F6ITU/ET-EER-Project/DJ1MR/2018 EER-ET documentation/Hermes-Interface-EER-Menu.pdf

# 2. Pulse Width Modulation (PWM) using Hermes and PowerSDR software

DJ1MR

# PWM principles, PWM spectrum

■ | The width of pulses is varied in proportion to the instantaneous amplitude of the SSB envelope

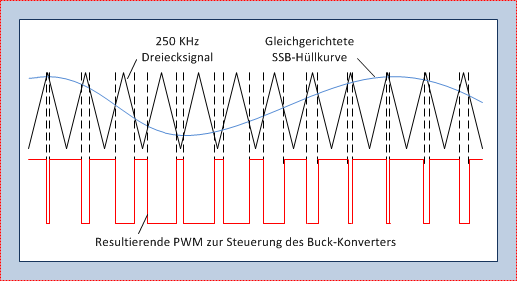
[picture p49: figure]

■ | The digital PWM signal has more bandwidth than the original SSB signal (25 to 32 KHz)
■ | Around the switching carrier and the harmonic carriers you see also the digital PWM LSB and USB

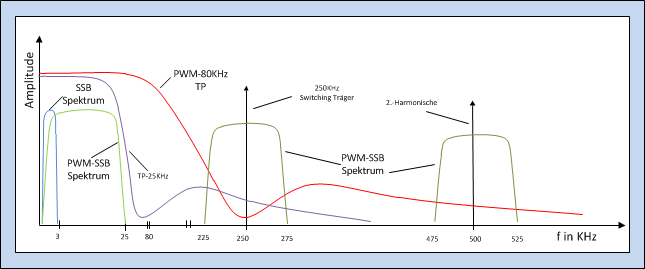
[picture p50: figure]

# Getting PWM from Hermes board on J14/Pin2

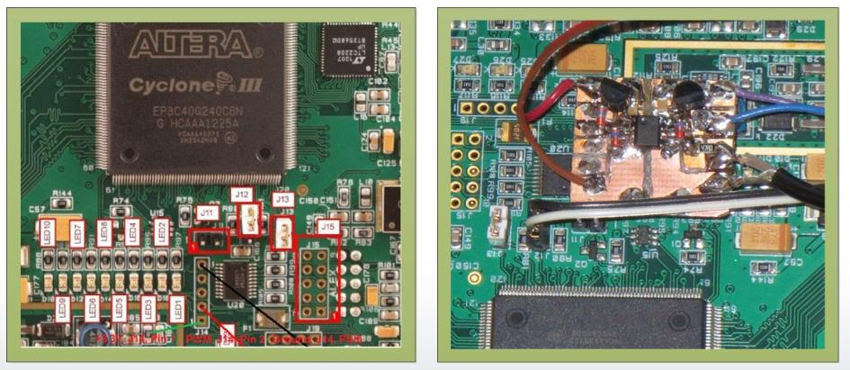
[picture p51: figure]

DJ1MR | 3

# Circuit diagram PWM adapter

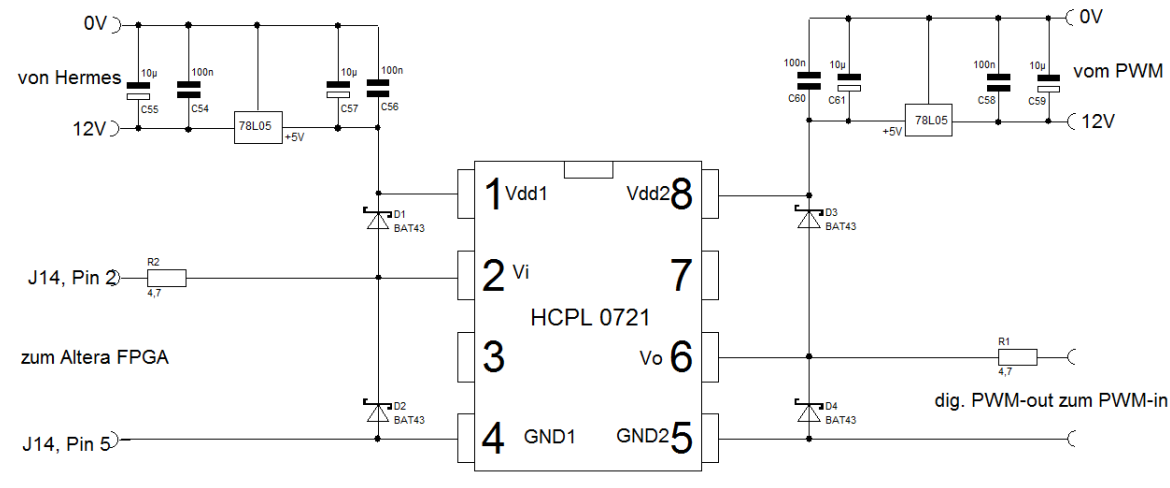
[picture p52: figure]

DJ1MR | 4

# PWM Two Tone and Analog PWM Envelope Signal

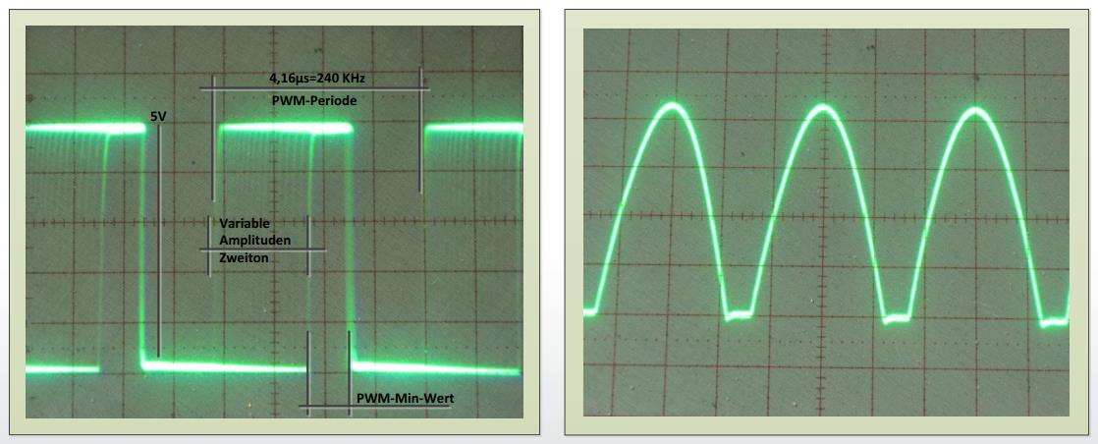
[picture p53: figure]

DJ1MR | 5
Digital 5 volts PWM | Filtered Analog Envelope Signal

# EER menu in Power SDR software

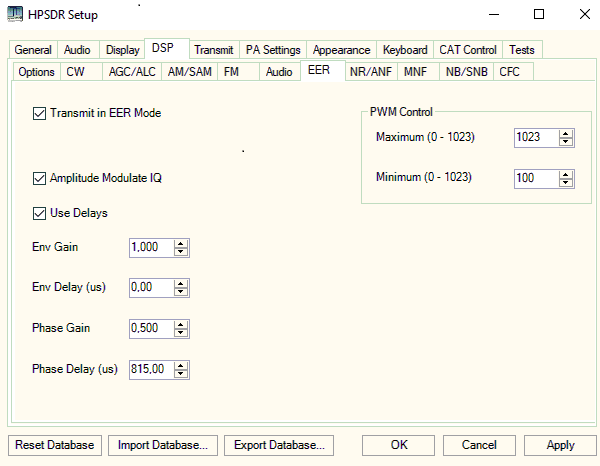
[picture p54: figure]

# PWM control function in PowerSDR

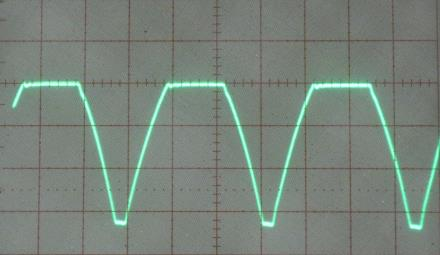
[picture p55: figure]
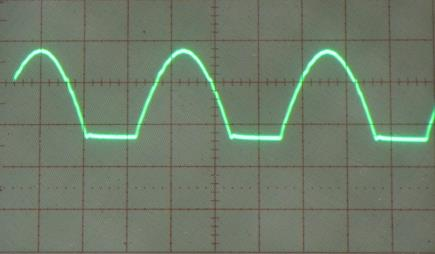
[picture p56: figure]
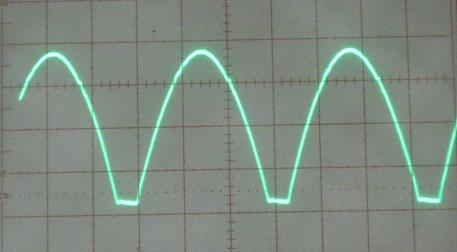
[picture p57: figure]
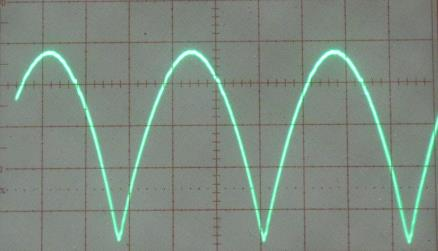
[picture p58: figure]

EER Mode | ET Mode | ET Mode | ET Mode

# Time alinment between Envelope and Phase

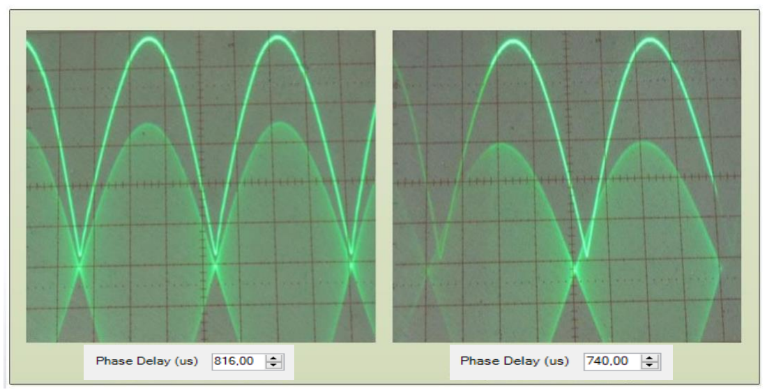
[picture p59: figure]

DJ1MR | 8

# Two types of SSB Phase Signals

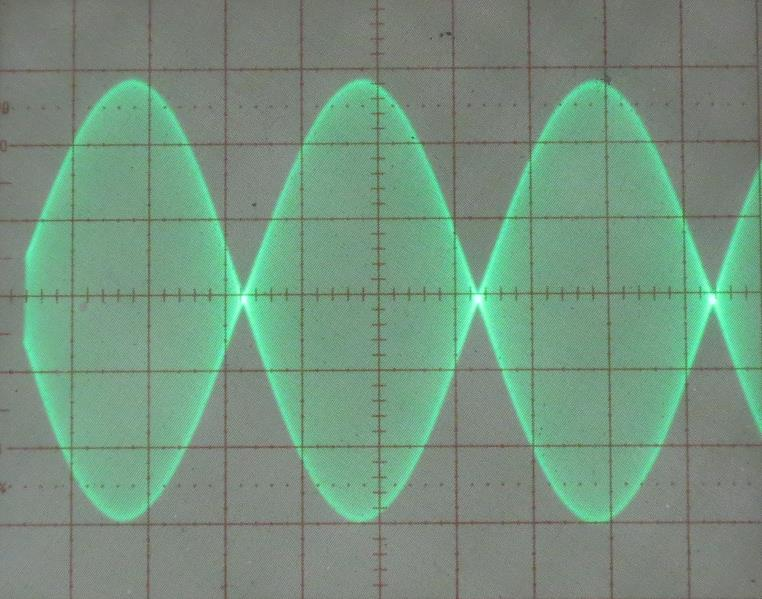
[picture p60: figure]
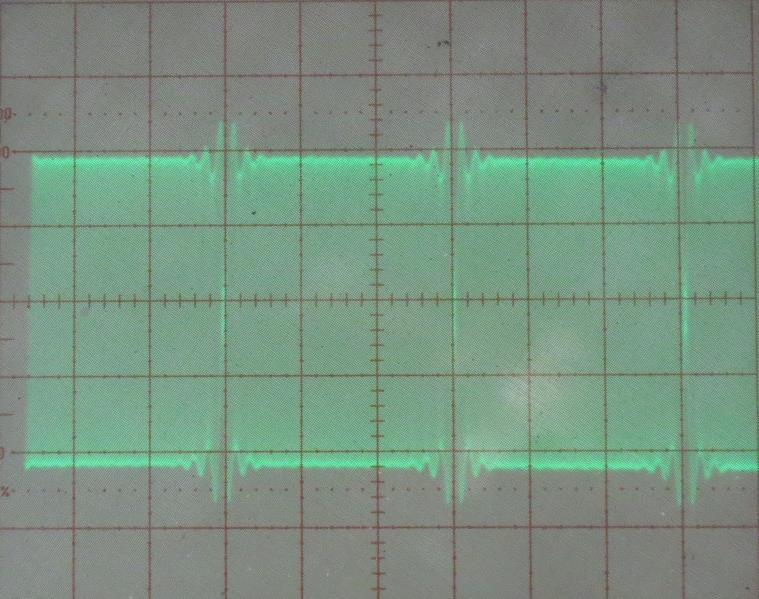
[picture p61: figure]

Amplitude Modulate Phase Signal | Constant Amplitude Phase Signal

# PWM Class S-modulator

■ | In PWM the most widely used high-level modulator is class S
■ | A transistor and diode act as a two-pole switch to generate a rectangular waveform with a switching frequency several times that of the output signal (for instance 240 KHz and higher).

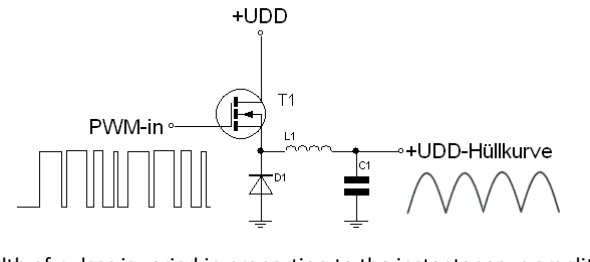
[picture p62: figure]

■ | The width of pulses is varied in proportion to the instantaneous amplitude of the desired output signal, which is recovered by a low-pass filter.
■ | Class S is ideally 100% efficient and it can have high efficiency over a wide dynamic range.

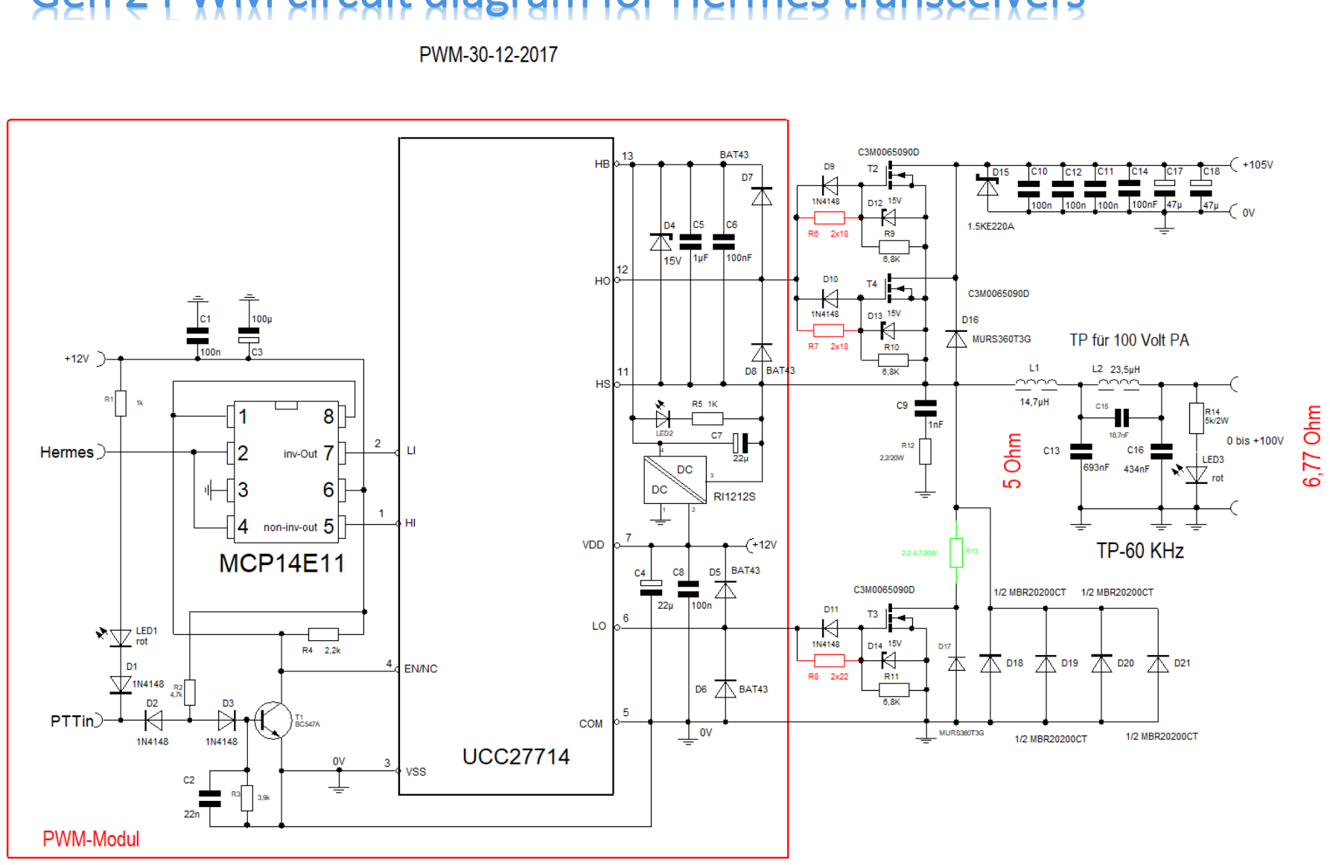
[picture p63: figure]

## Gen 2 PWM circuit diagram for Hermes transceivers

# Impulses on HS PIN UCC27714

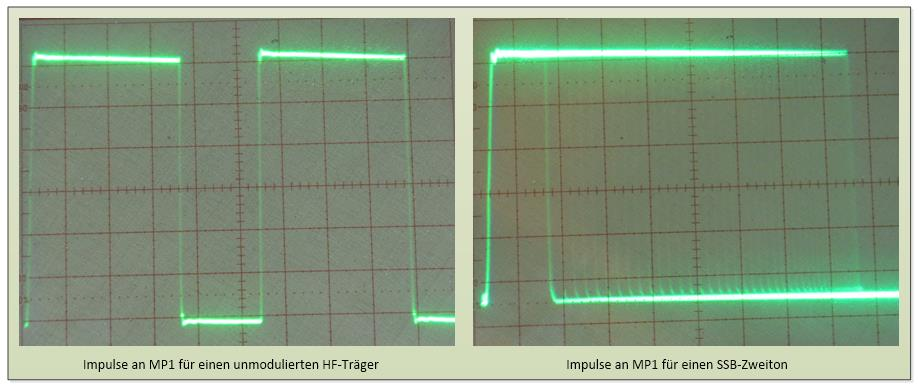
[picture p64: figure]

DJ1MR | 12

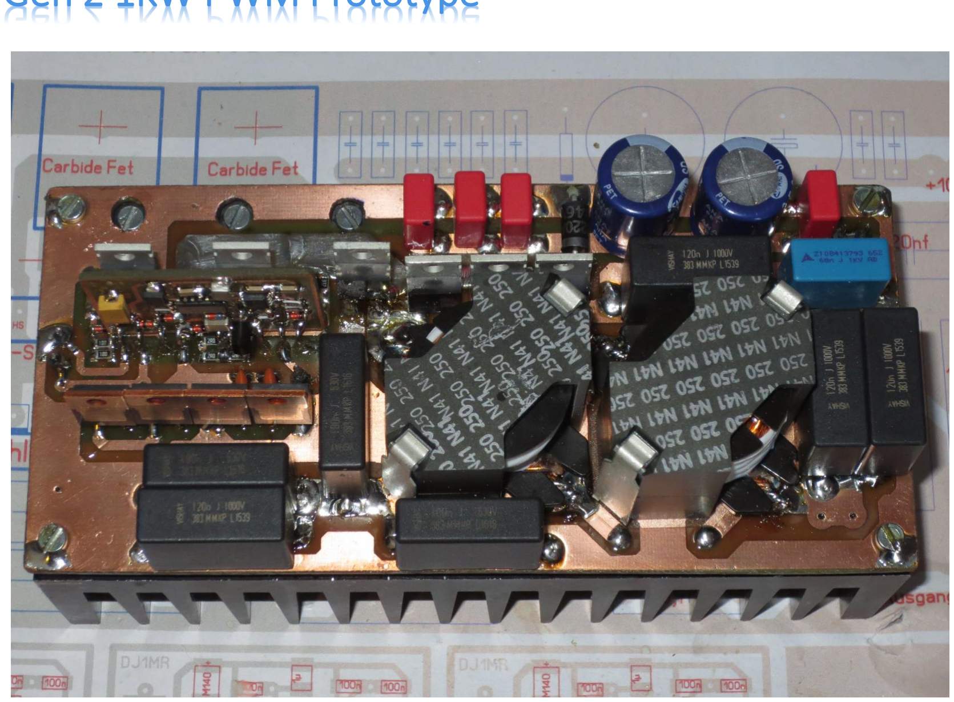
[picture p65: figure]

## Gen 2 1KW PWM Prototype

# PWM control driver modul

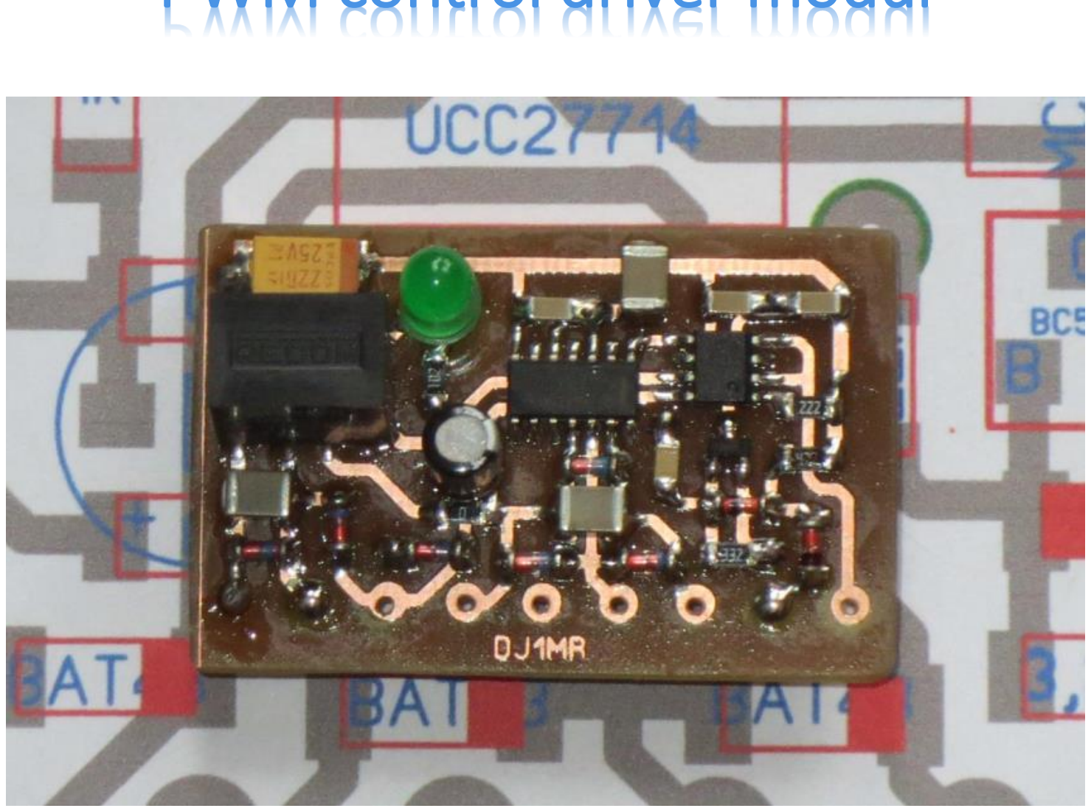
[picture p66: figure]

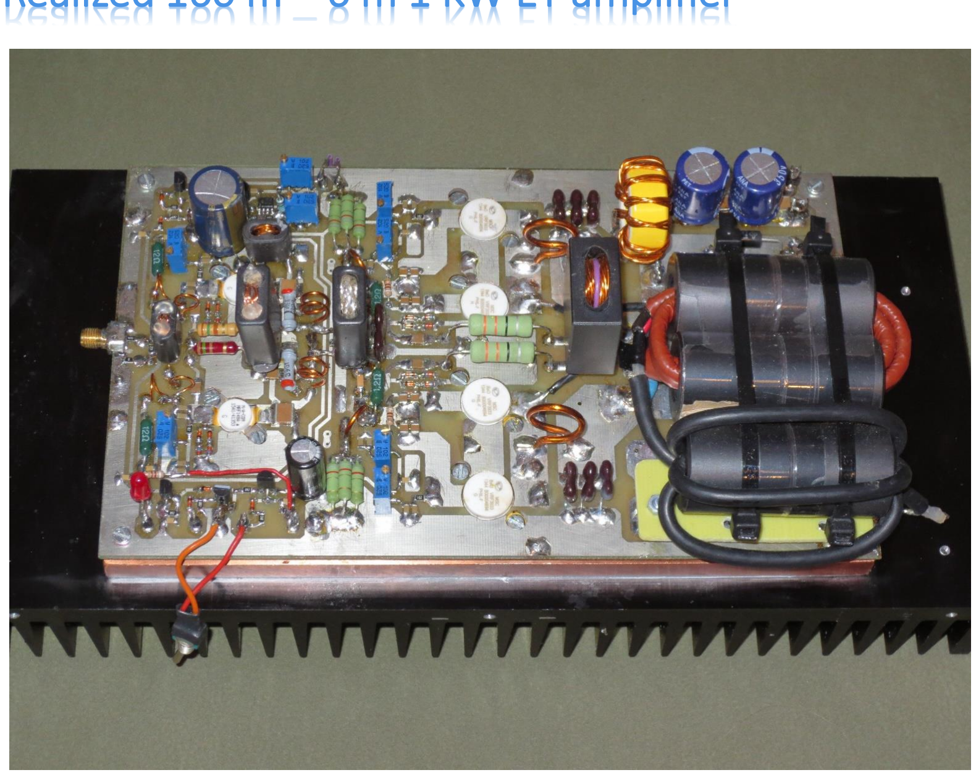
[picture p67: figure]

## Realized 160 m – 6 m 1 KW ET amplifier

# IMD3 with linearity 750 W out

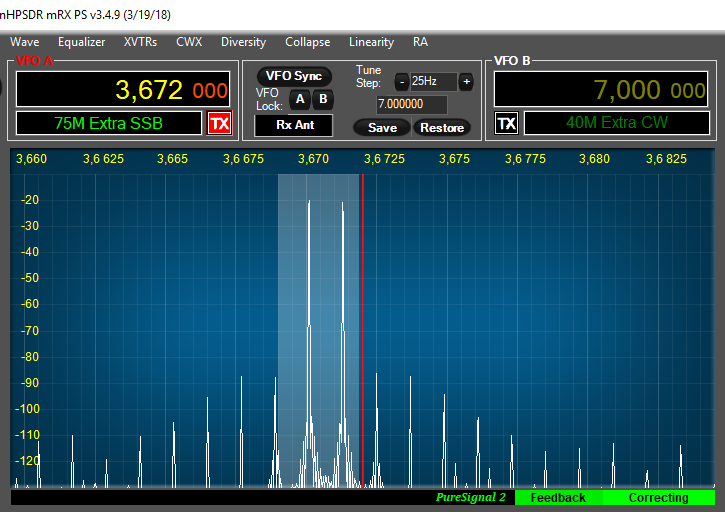
[picture p68: figure]

DJ1MR | 16

# Linearity correction with PowerSDR

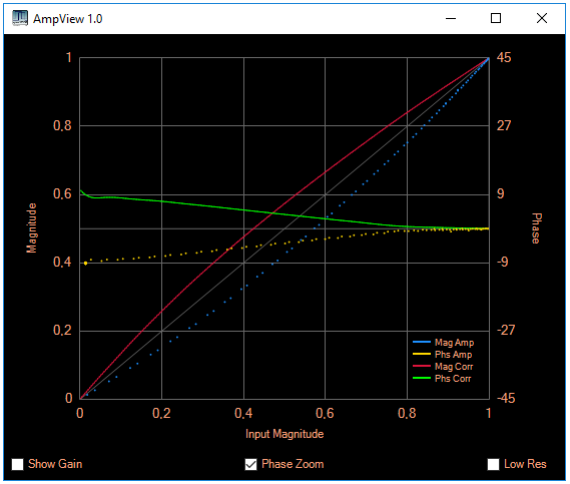
[picture p69: figure]

■ | AmpView ET PA 750 Watt
■ | No memory effect
