F6ITU/ET-EER-Project/DJ1MR/2018 EER-ET documentation/Vortrag-HAM-2018-DJ1MR-V3.pdf

# TRANSMITTER ARCHITECTURES FOR HIGH EFFICIENCY AMPLIFICATION

## using

## PowerSDRsoftware and Hermes firmware

Ruediger Moeller/callsign DJ1MR

## The dissipated heat dilemma

■ | Legacy linear RF power amplifiers consume large amounts of energy,
■ | dissipate heat take up space in RF power amplifiers,
■ | large heatsinks are increasing the weight and the expenses of the PA,
■ | fans are generating often too much noise,
■ | Significantly more efficient PA technology will be the future goal
■ | Basic requirements for future power amplifier technology
□ | high linearity,
□ | high efficiency
□ | smaller dimensions
□ | greater output power levels

### DJ1MR

# 1. Supply Modulated Transmitters

## Principles of Supply Modulated Transmitters

■ | Envelope Elimination and Restoration (EER), (Kahn technique)
■ | Hybrid Envelope Elimination and Restoration (H-EER)
■ | Envelope Tracking (ET).
■ | EER
■ | EER technique combines a highly efficient, but nonlinear RF PA with a highly
efficient envelope amplifier to implement a high-efficiency linear RF PA.

□ In its classic form, a limiter eliminates the envelope and allowing the constant-amplitude phase modulated carrier to be amplified efficiently by class-C, class-D, class-E, or class-F RF PAs.

□ Amplitude modulation of the final RF PA restores the envelope to the phase-modulated carrier creating an amplified replica of the input signal.

## Transmitter based upon the Kahn EER technique

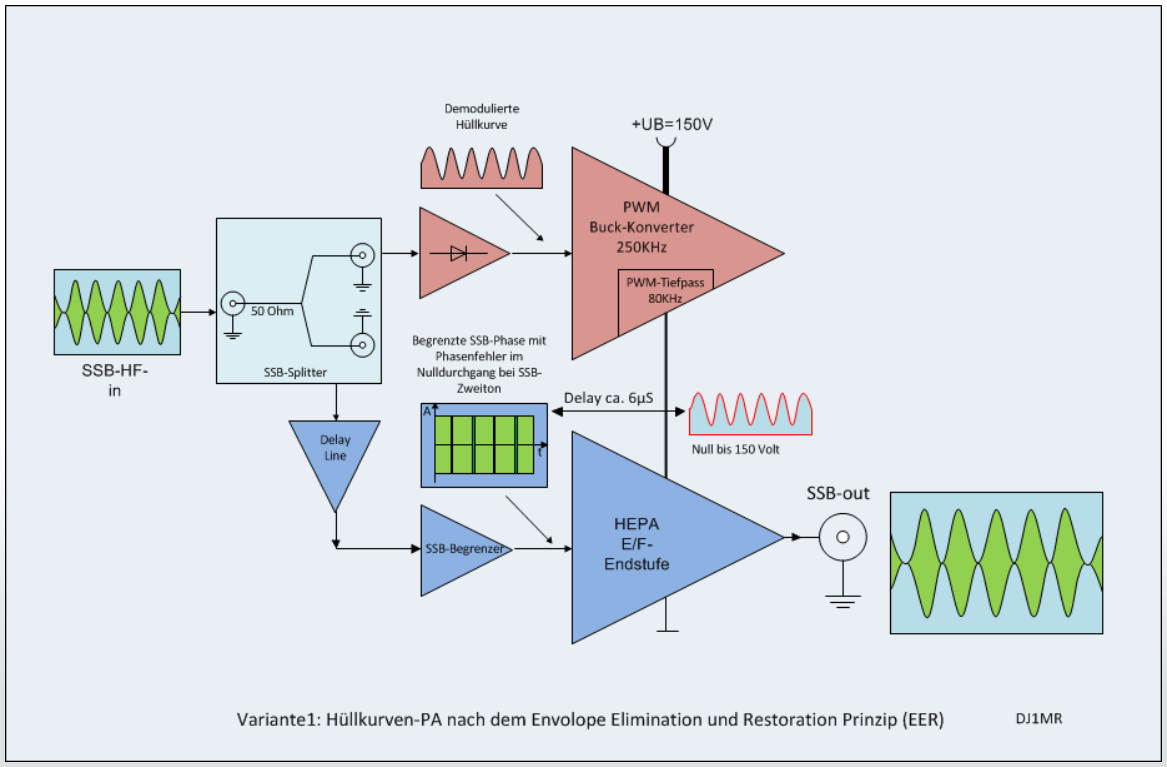
[picture p92: figure]

## Principles of supply-modulated transmitters

■ | ET
■ | the input signal of the PA is not a constant envelope signal with phase information but a complex-signal envelope
■ | the ET transmitter has advantages of the H-EER transmitter, such as less precise time alignment between the envelope and RF paths.
■ | the envelope signal injected into the PA is no longer the original envelope and is adjusted for optimized performance
■ | V-offset is a bit greater than the knee voltage of the power mosfets and the severely nonlinear behavior caused by nonlinear capacitance impedance mismatch of the PA is prevented
■ | traditionally, linear PAs such as class-AB amplifiers, are utilized in ET transmitters to obtain good linearity with high efficiency
■ | the burden of sufficient IMD3 lays only on the HEPA

## Transmitter based upon ET technique

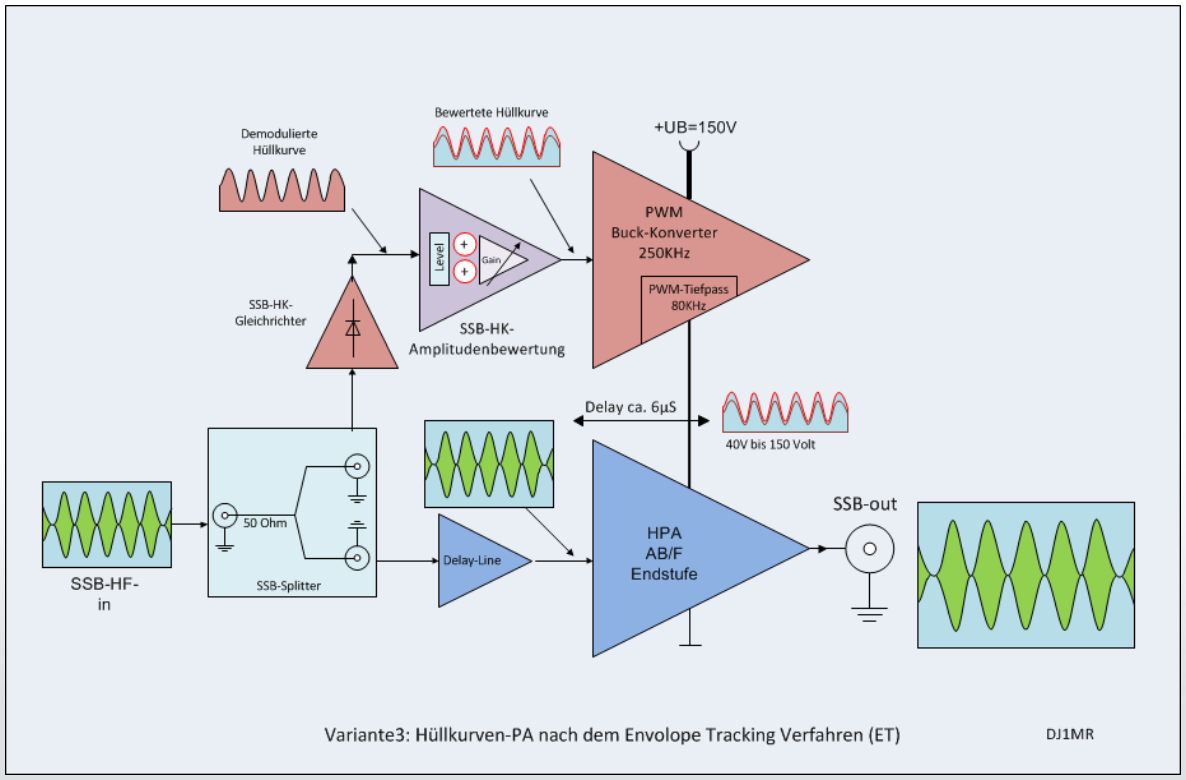
[picture p93: figure]

## Modulation schemes of the power supply

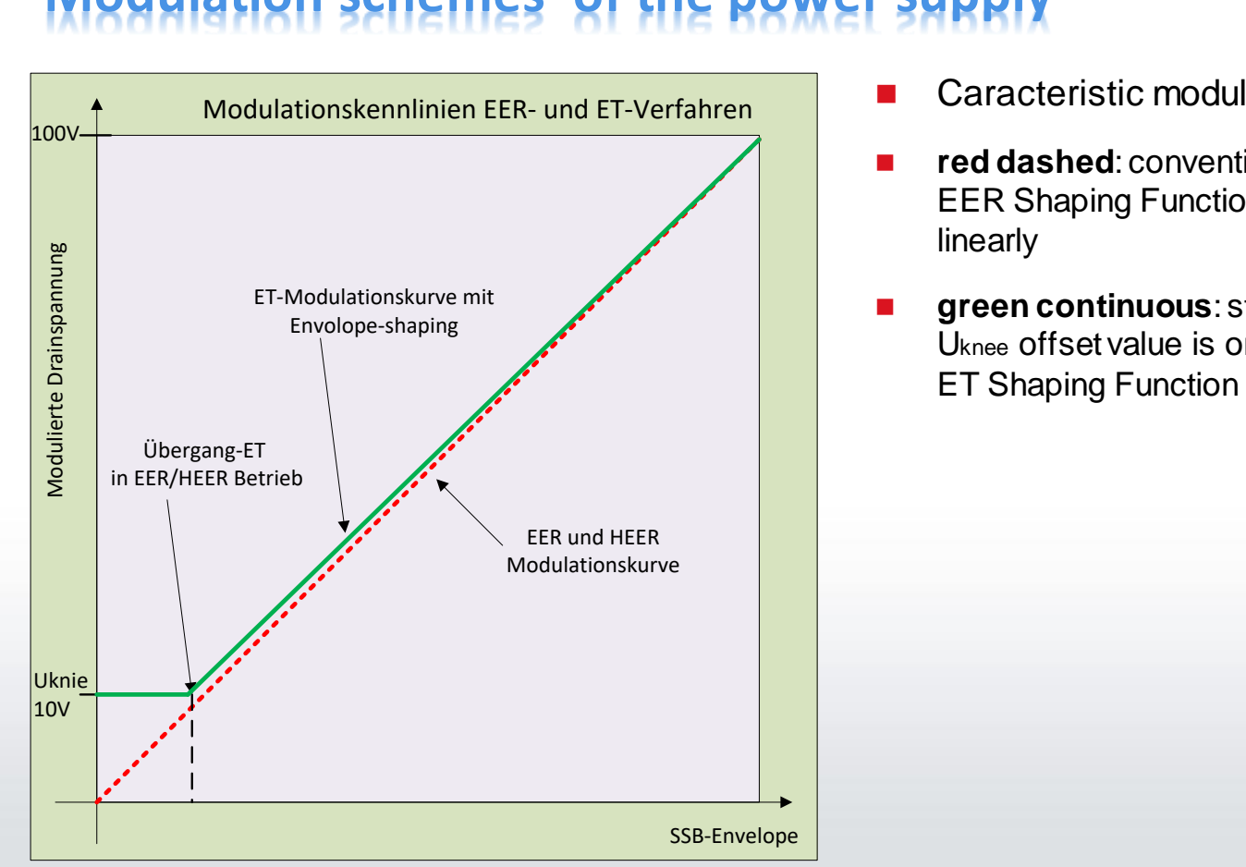
[picture p94: figure]
linearly; ET Shaping Function; Übergang-ET in EER/HEER Betrieb; EER und HEER Modulationskurve; SSB-Envelope

■ | Caracteristic modulation lines
■ | red dashed: conventional EER/H- EER Shaping Function, increases
■ | green continuous: starts with Uknee offset value is one Type of

# DJ1MR Modulierte Drainspannung Uknie 10V

ET-Modulationskurve mit Envolope-shaping

Modulationskennlinien EER- und ET-Verfahren

# 2. Pulse Width Modulation (PWM) using Hermes and PowerSDR software

## PWM principles, PWM spectrum

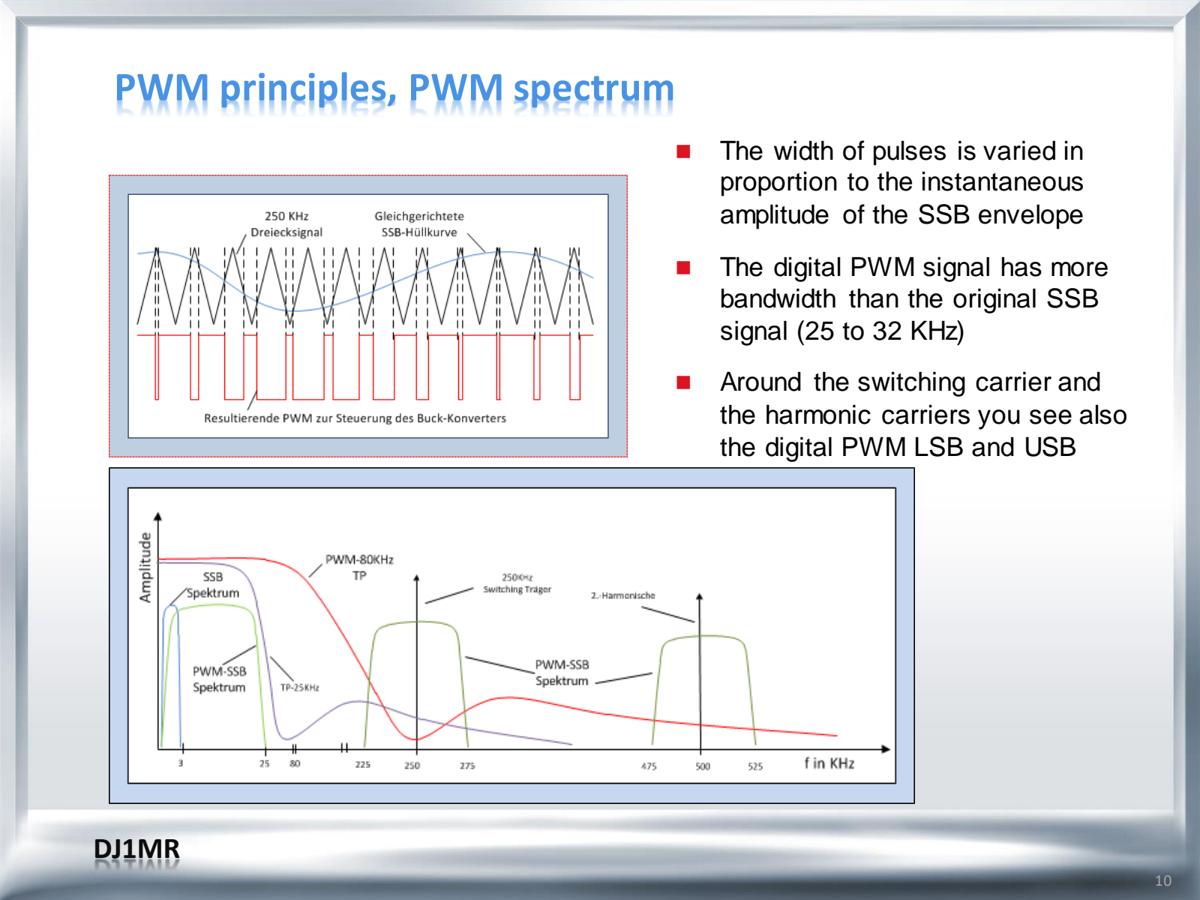
[picture p95: page 10]

■ | The width of pulses is varied in proportion to the instantaneous amplitude of the SSB envelope
■ | The digital PWM signal has more bandwidth than the original SSB signal (25 to 32 KHz)
■ | Around the switching carrier and the harmonic carriers you see also the digital PWM LSB and USB

## Getting PWM from Hermes board on J14/Pin2

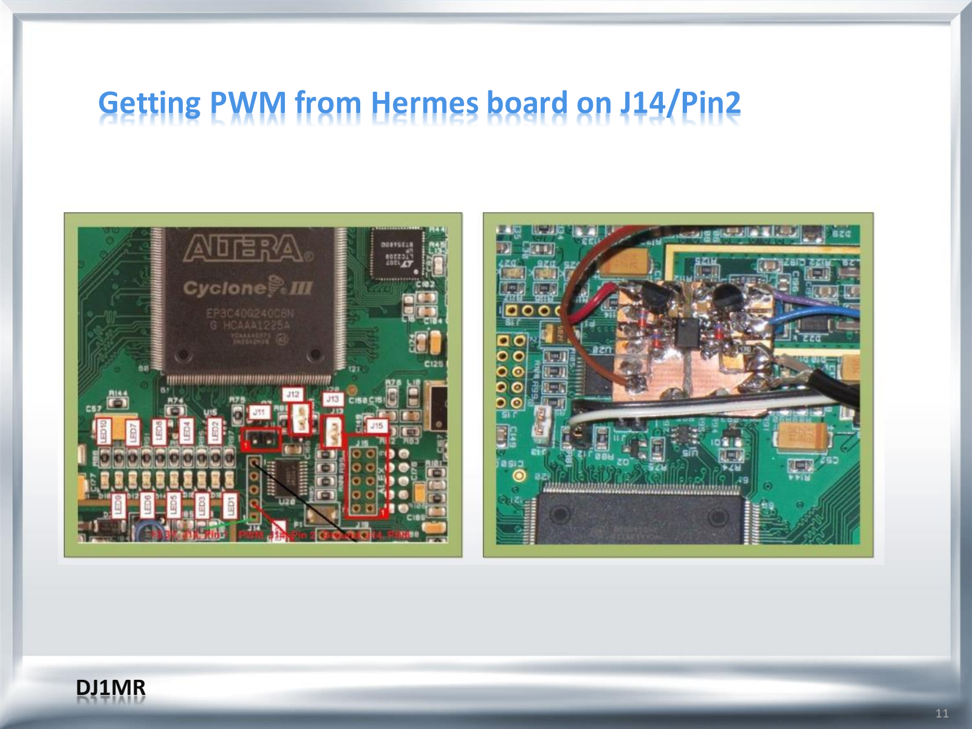
[picture p96: page 11]

## Circuit diagram PWM adapter

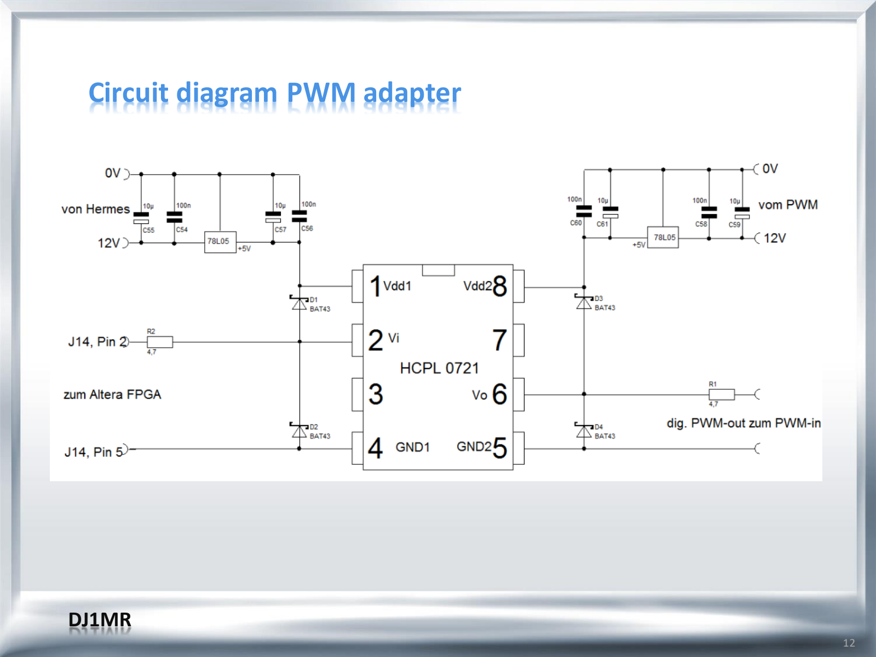
[picture p97: page 12]

## PWM Two Tone and Analog PWM Envelope Signal

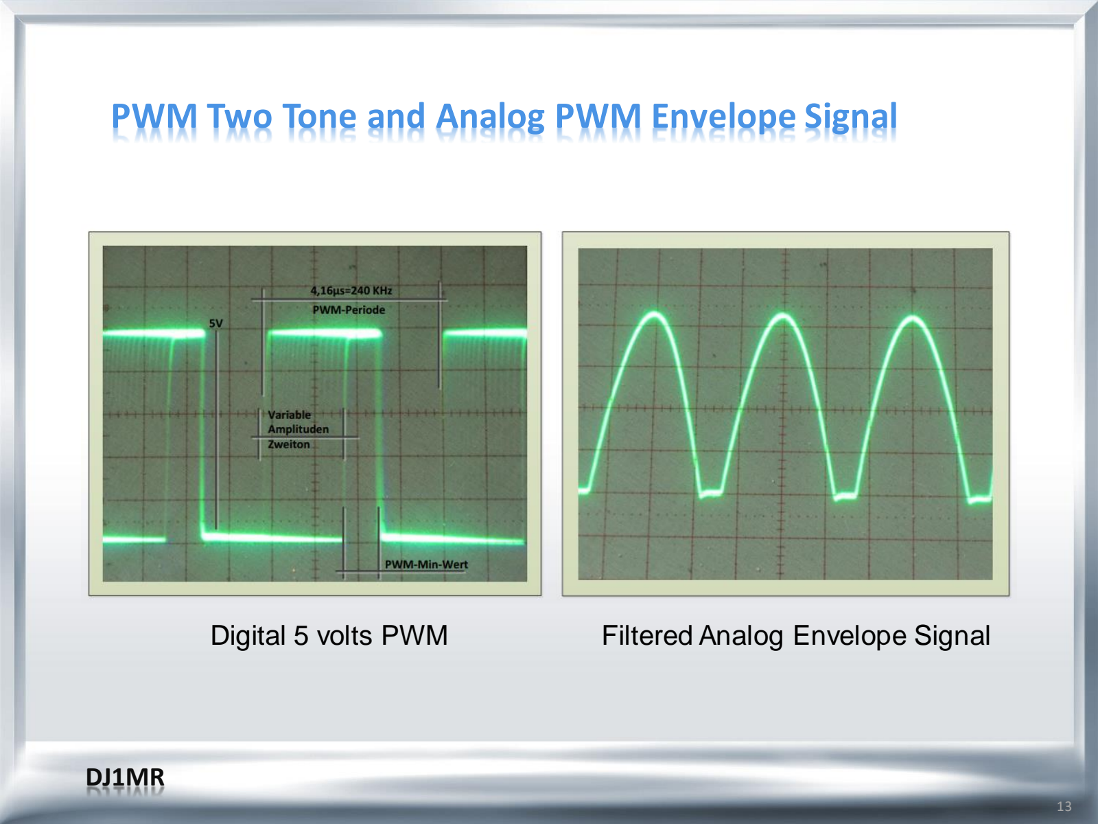
[picture p98: page 13]

Digital 5 volts PWM | Filtered Analog Envelope Signal

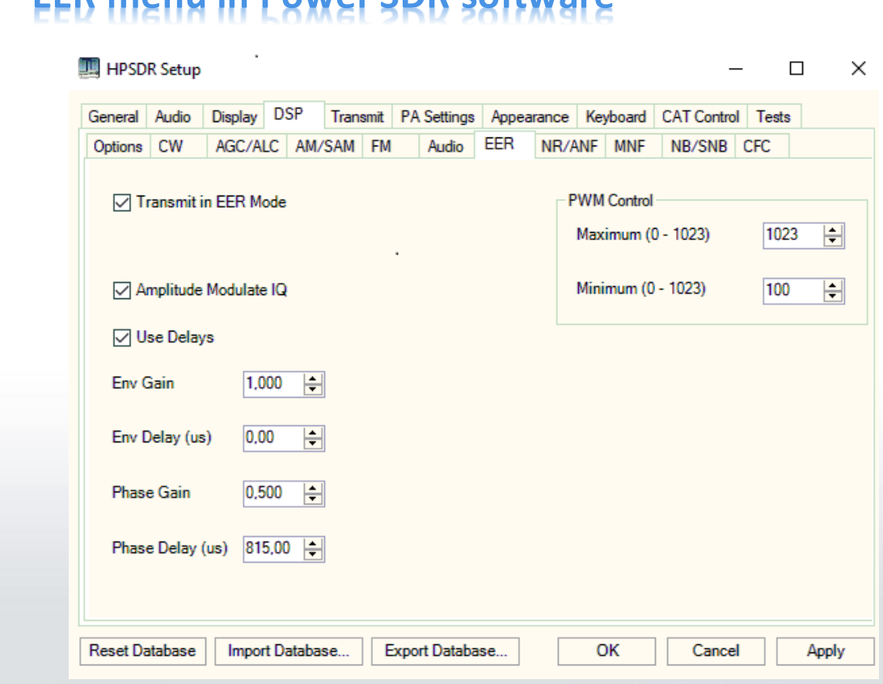
[picture p99: figure]

## EER menu in Power SDR software

## PWM control function in PowerSDR

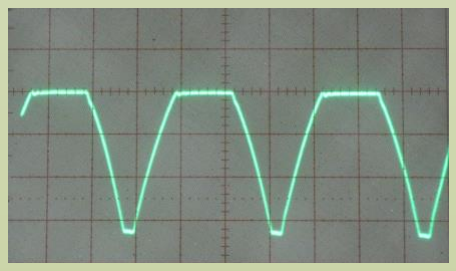
[picture p100: figure]
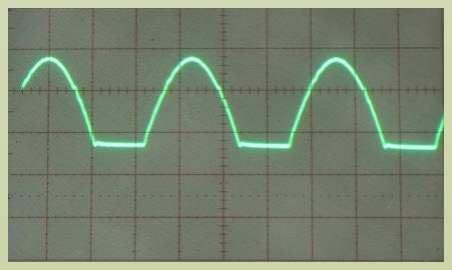
[picture p101: figure]
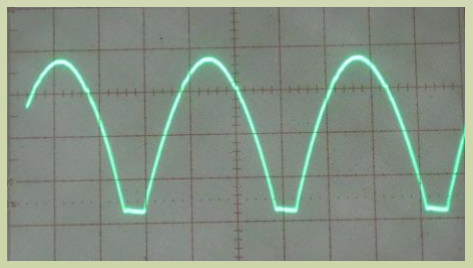
[picture p102: figure]
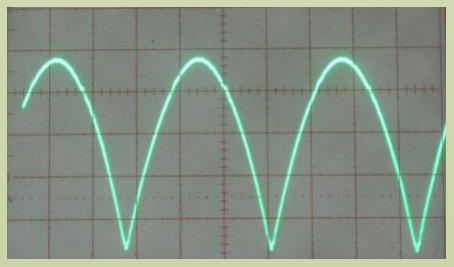
[picture p103: figure]

EER Mode | ET Mode | ET Mode | ET Mode

## Time alinment between Envelope and Phase

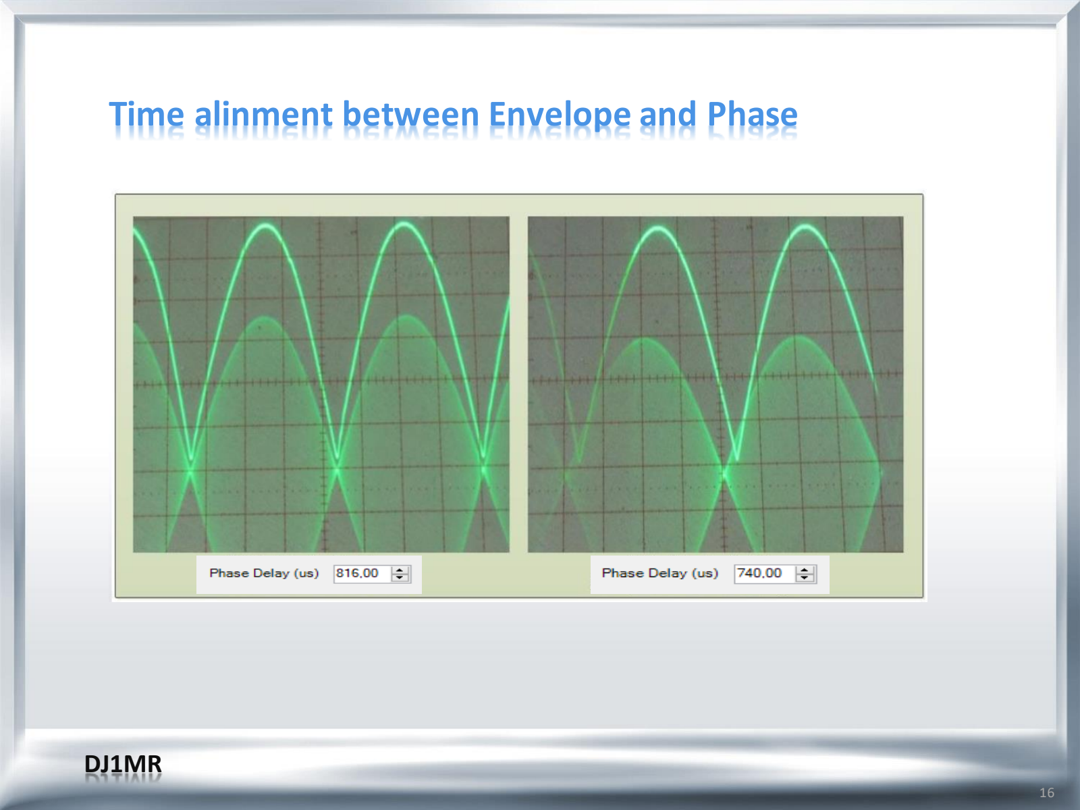
[picture p104: page 16]

## Two types of SSB Phase Signals

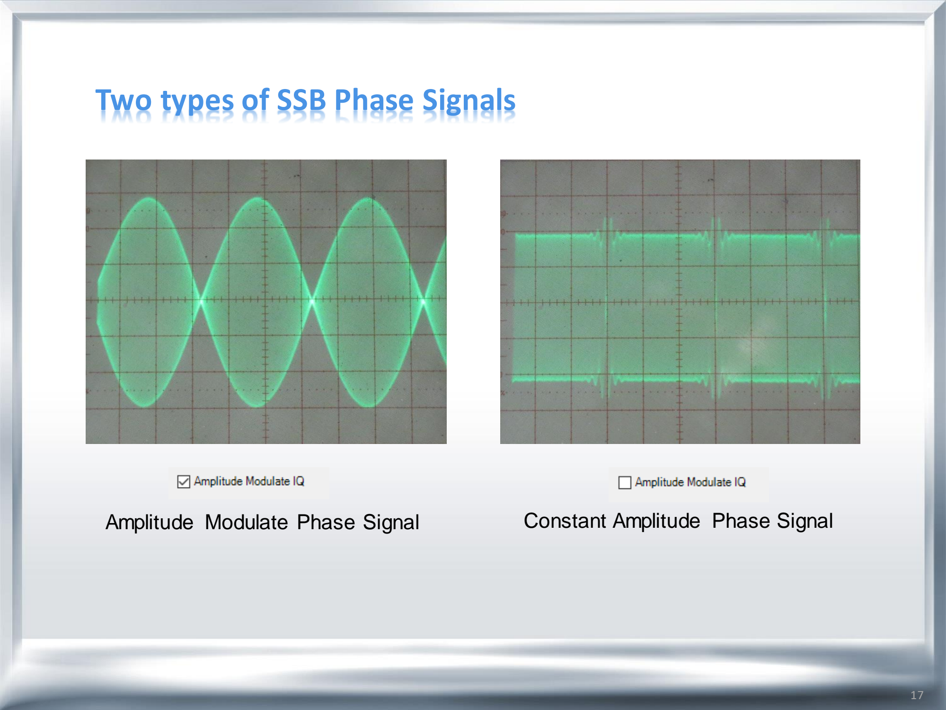
[picture p105: page 17]

Amplitude Modulate Phase Signal | Constant Amplitude Phase Signal

## PWM Class S-modulator

■ | In PWM the most widely used high-level modulator is class S
■ | A transistor and diode act as a two-pole switch to generate a rectangular waveform with a switching frequency several times that of the output signal (for instance 240 KHz and higher).

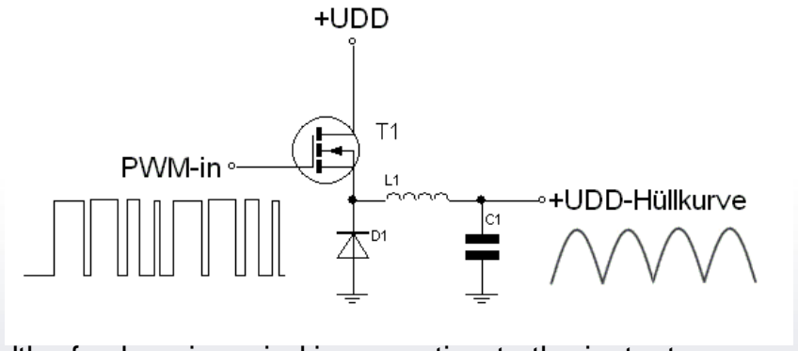
[picture p106: figure]

■ | The width of pulses is varied in proportion to the instantaneous amplitude of the desired output signal, which is recovered by a low-pass filter.
■ | Class S is ideally 100% efficient and it can have high efficiency over a wide dynamic range.

## Gen 2 PWM circuit diagram for Hermes transceivers

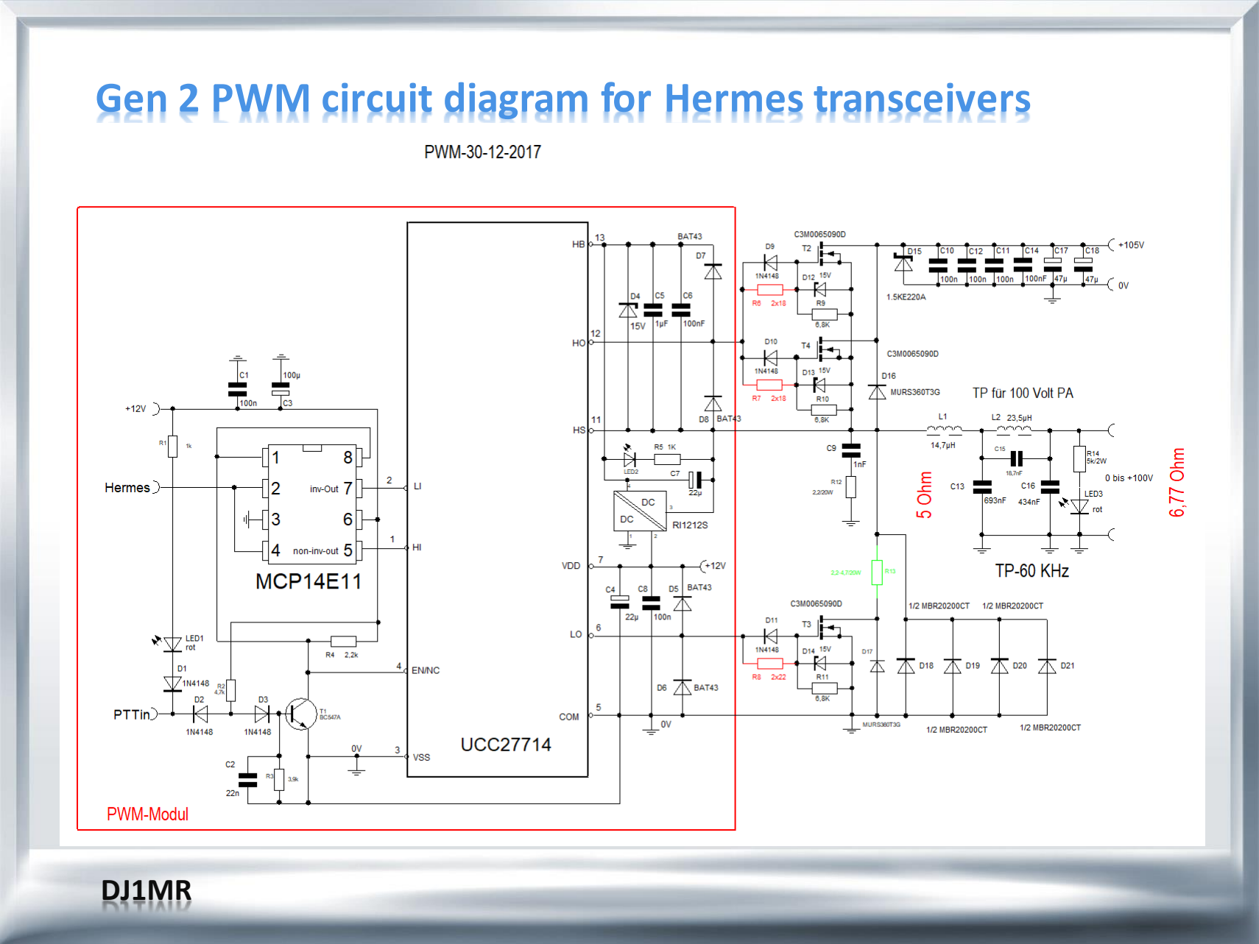
[picture p107: page 19]

## Impulses on HS PIN UCC27714

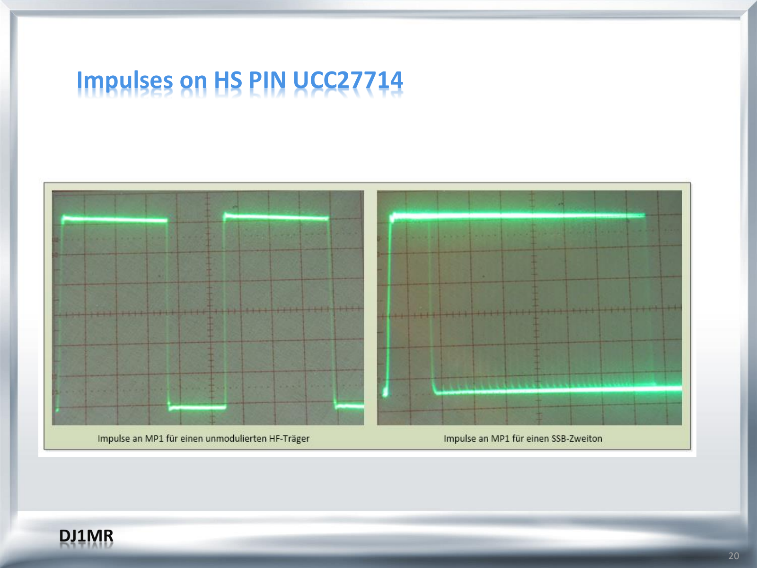
[picture p108: page 20]

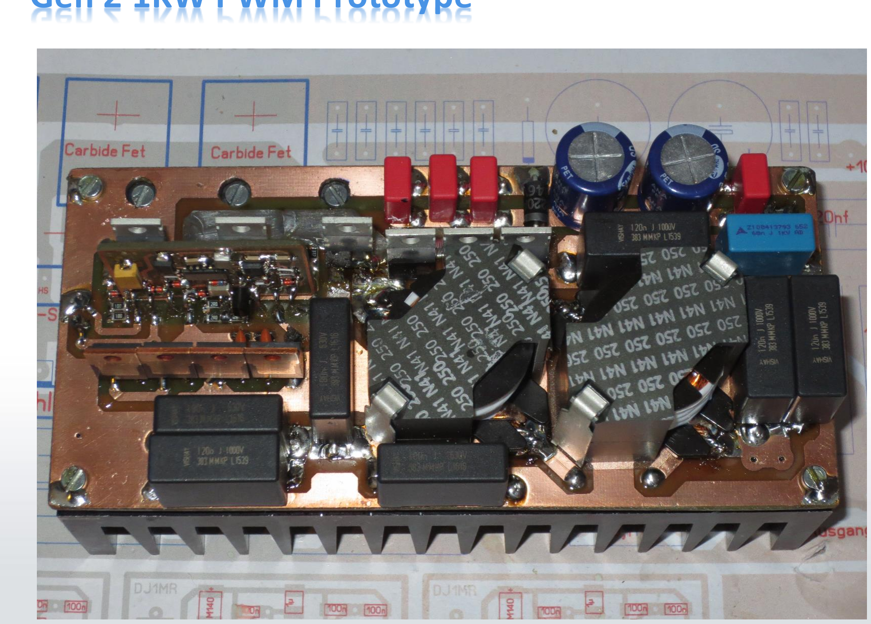
[picture p109: figure]

## Gen 2 1KW PWM Prototype

# PWM control driver modul

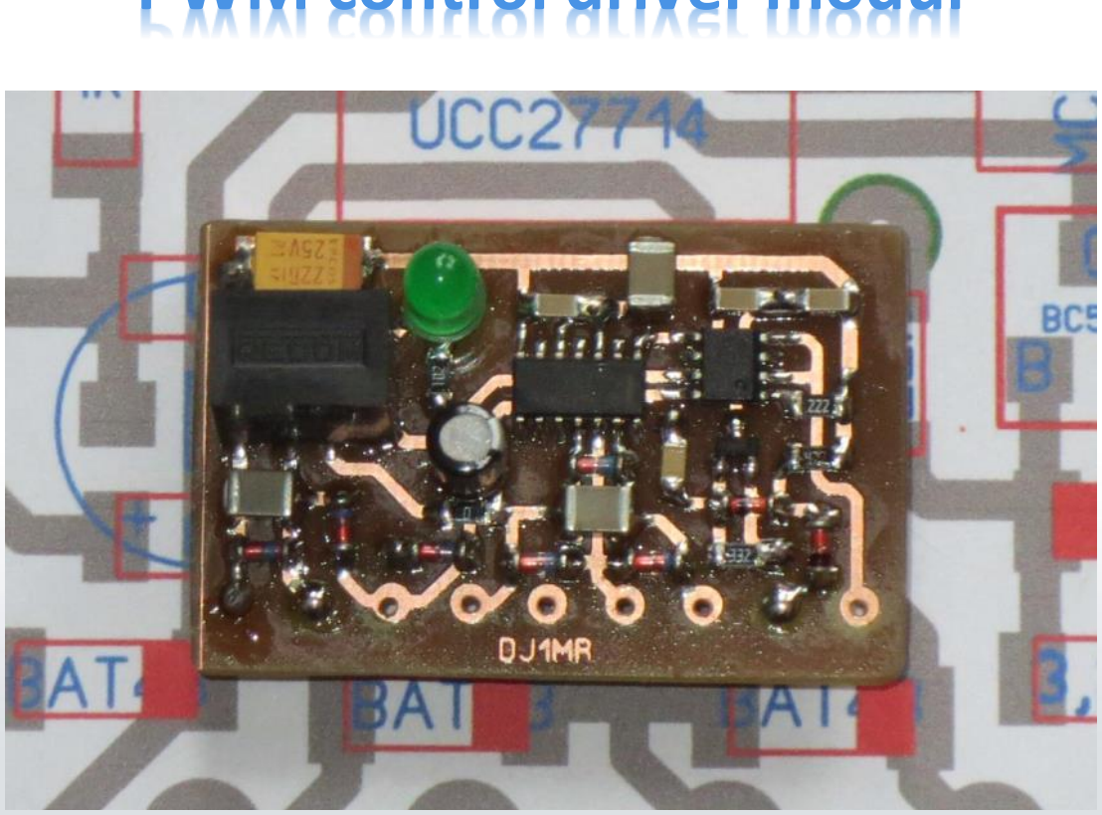
[picture p110: figure]

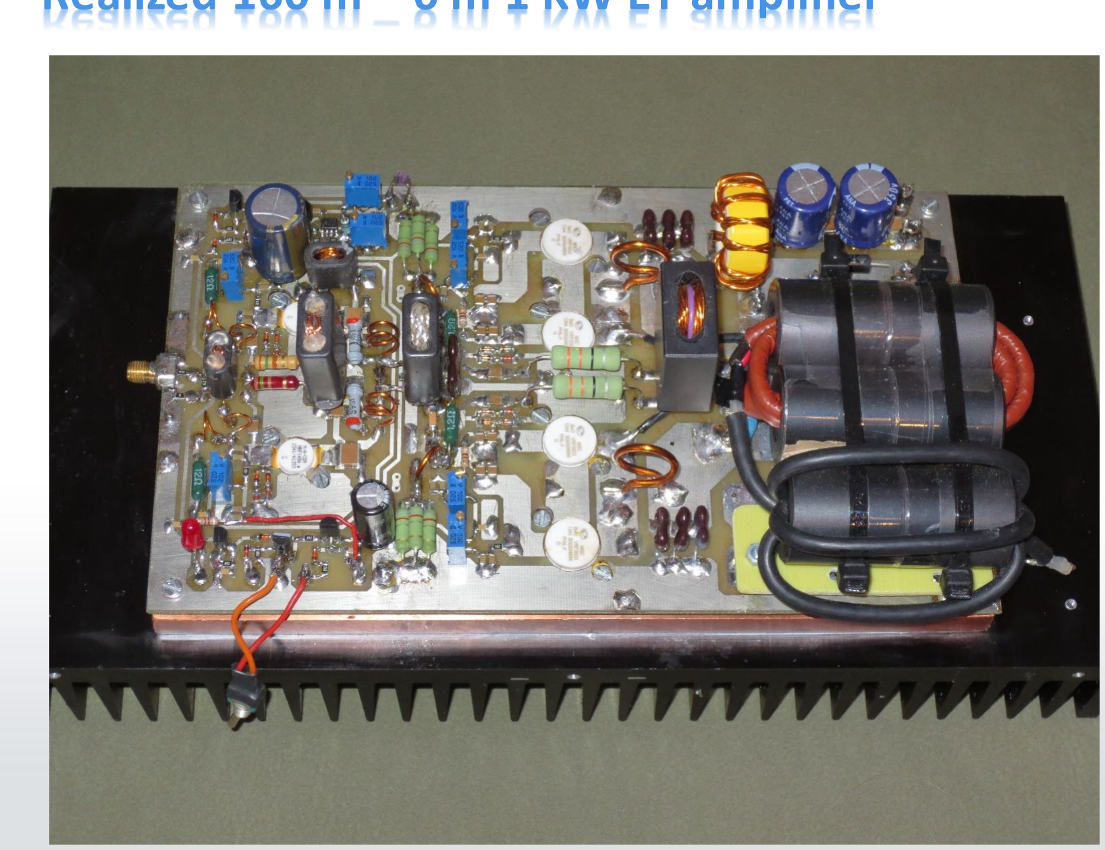
[picture p111: figure]

## Realized 160 m – 6 m 1 KW ET amplifier

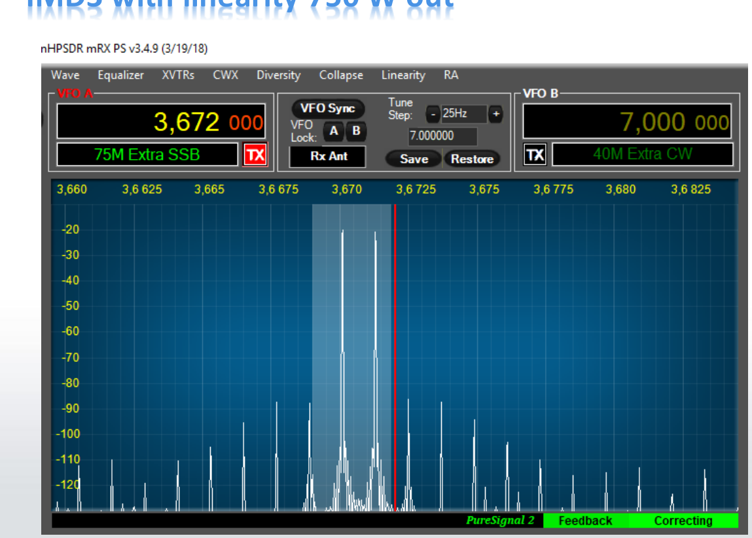
[picture p112: figure]

## IMD3 with linearity 750 W out

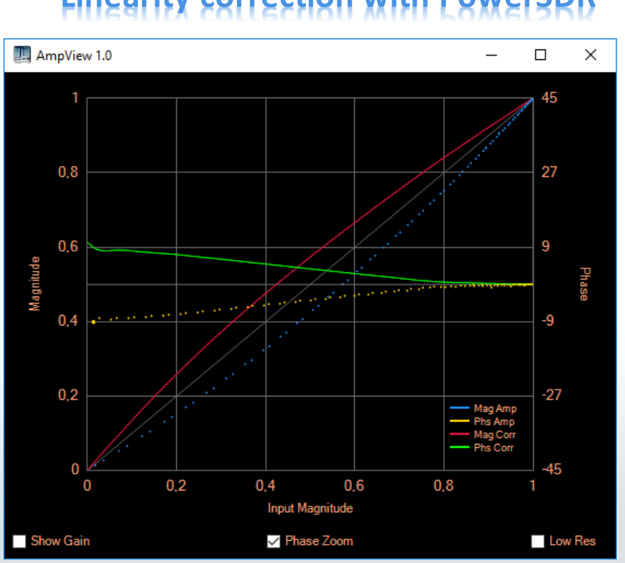
[picture p113: figure]

## Linearity correction with PowerSDR

■ | AmpView ET PA 750 Watt
■ | No memory effect

# 3. Helpful entry in PWM technology

## CREE Evaluation Board for Buck Converter

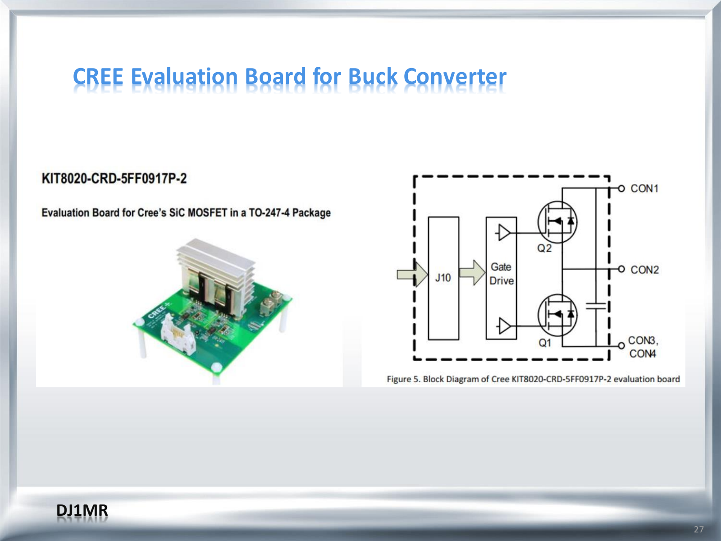
[picture p114: page 27]

## CREE Evaluation Board for Buck Converter

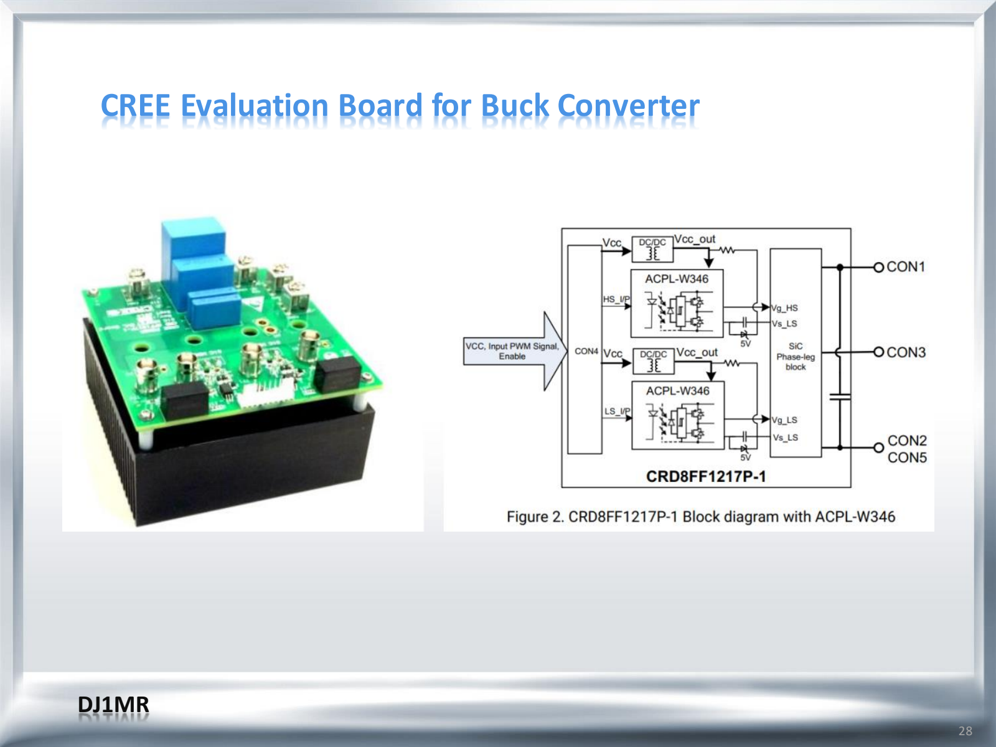
[picture p115: page 28]

## Full bridge converter with two CREE boards

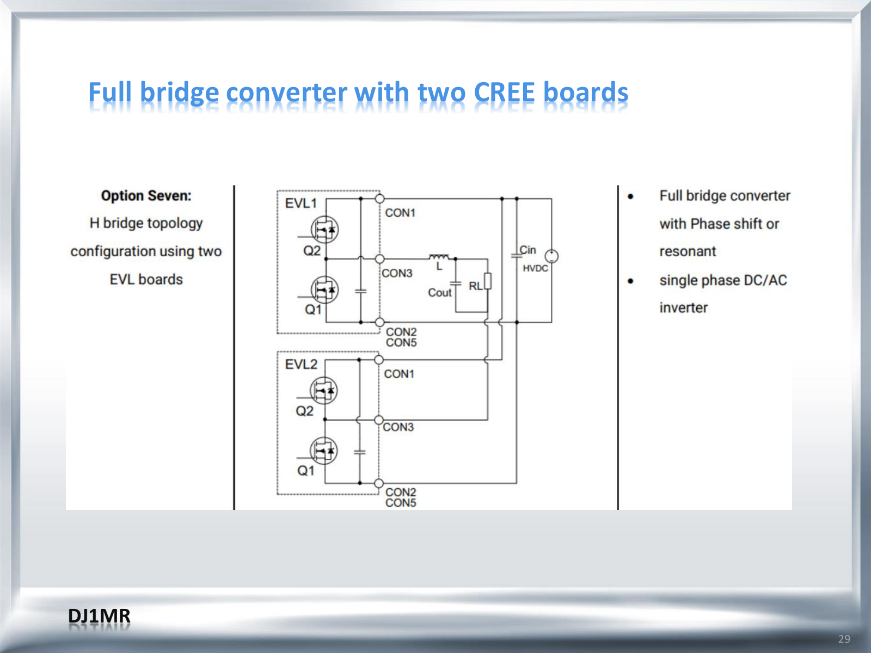
[picture p116: page 29]

## Usable Carbide Power Mosfets from CREE

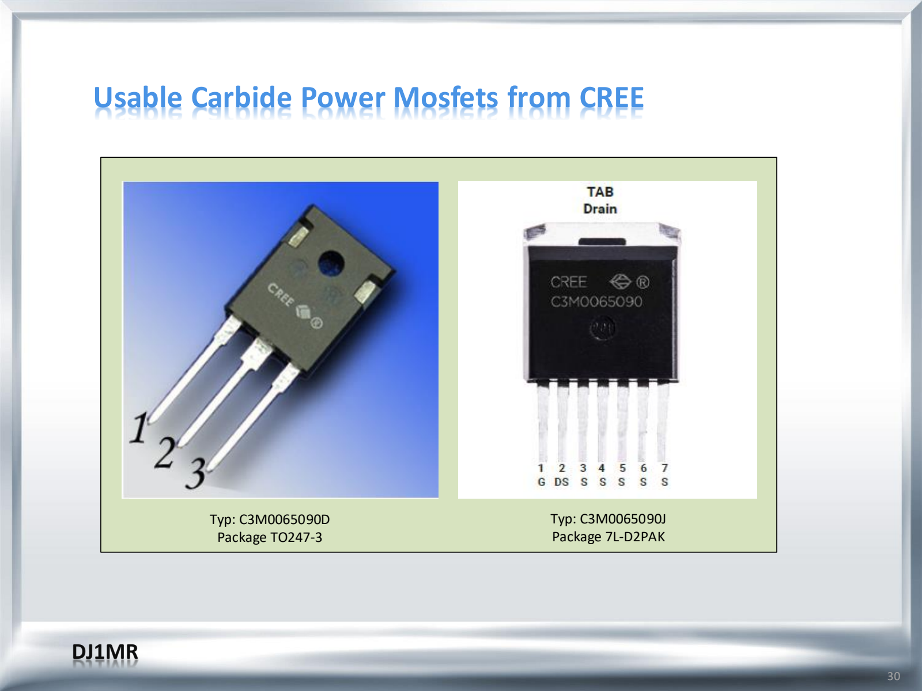
[picture p117: page 30]

Typ: C3M0065090D
Package TO247-3

Typ: C3M0065090J
Package 7L-D2PAK

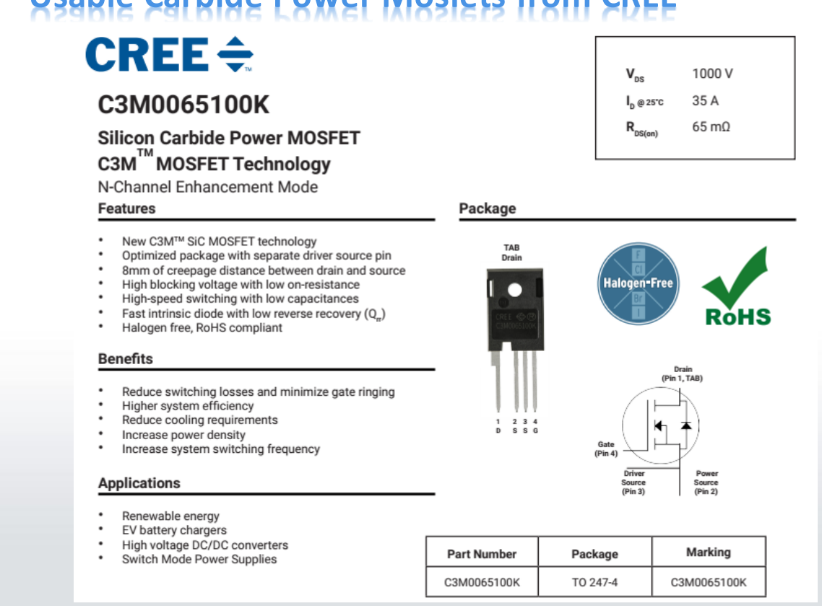
[picture p118: figure]

## Usable Carbide Power Mosfets from CREE

# 4. Optional:

# Switch Mode PA technology

## Switch mode PA technology

■ the main idea behind switch-mode PA technology is to operate the transistor in saturation,

■ | either voltage or current, depending on amplifier class, is switched on and off.
■ | For our discussion of fundamental properties,
□ | the transistor can be replaced by a switch.
□ | when the switch is open, only voltage is present over the transistor.
□ | when closed, current flows through it.
■ | Since there is no overlap in time between voltage and current, power is not
dissipated and one obtains 100% theoretical efficiency.

## Class E RF amplifier

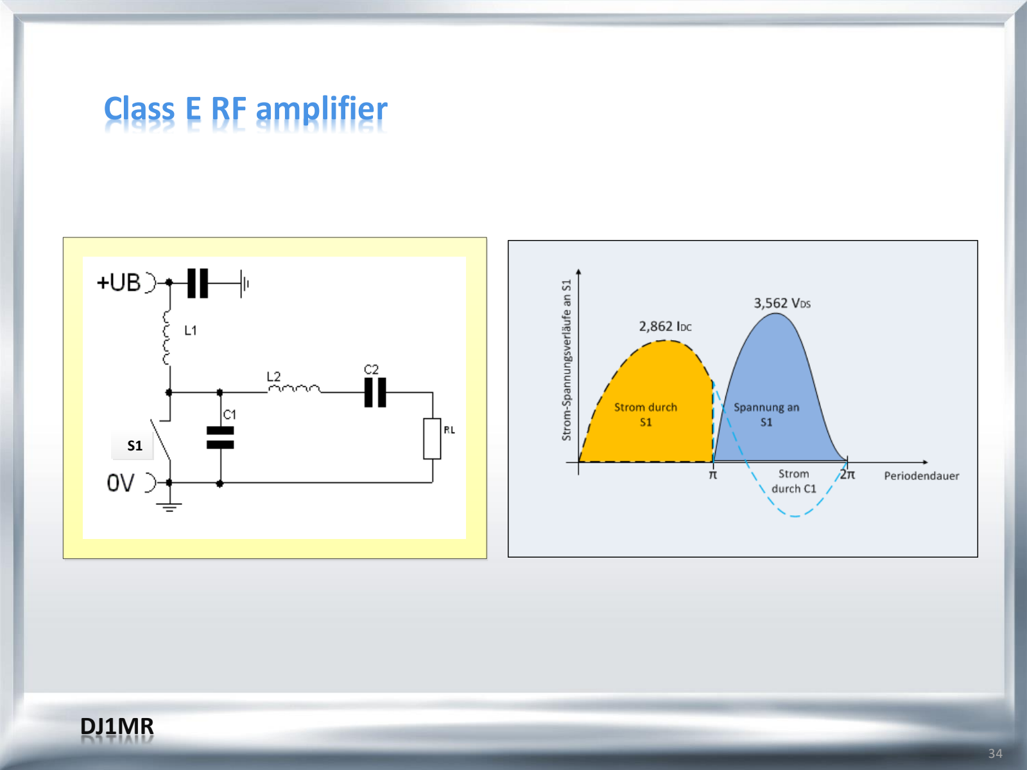
[picture p119: page 34]

# DJ1MRS1

## Class E RF amplifier simulation with Tonne freeware

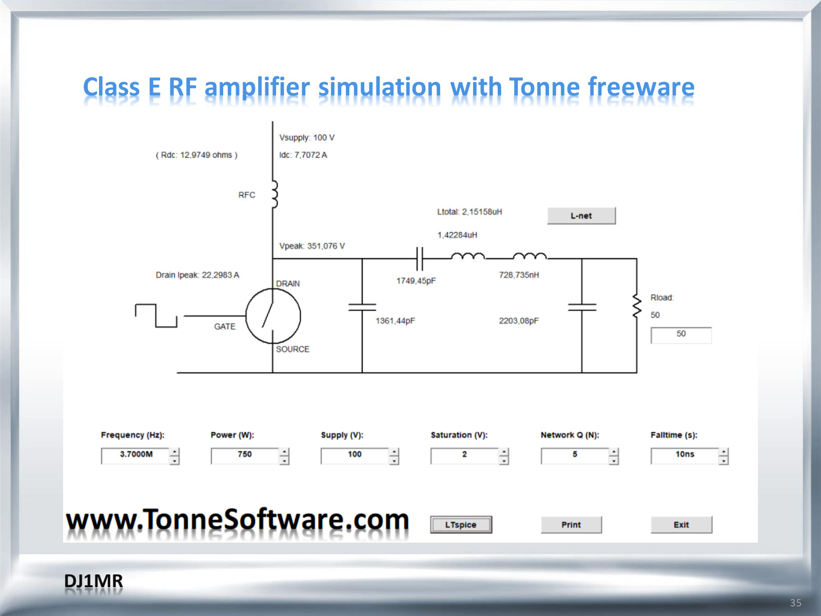
[picture p120: page 35]

## E-RF Power amplifier 750 Watt 80 meters

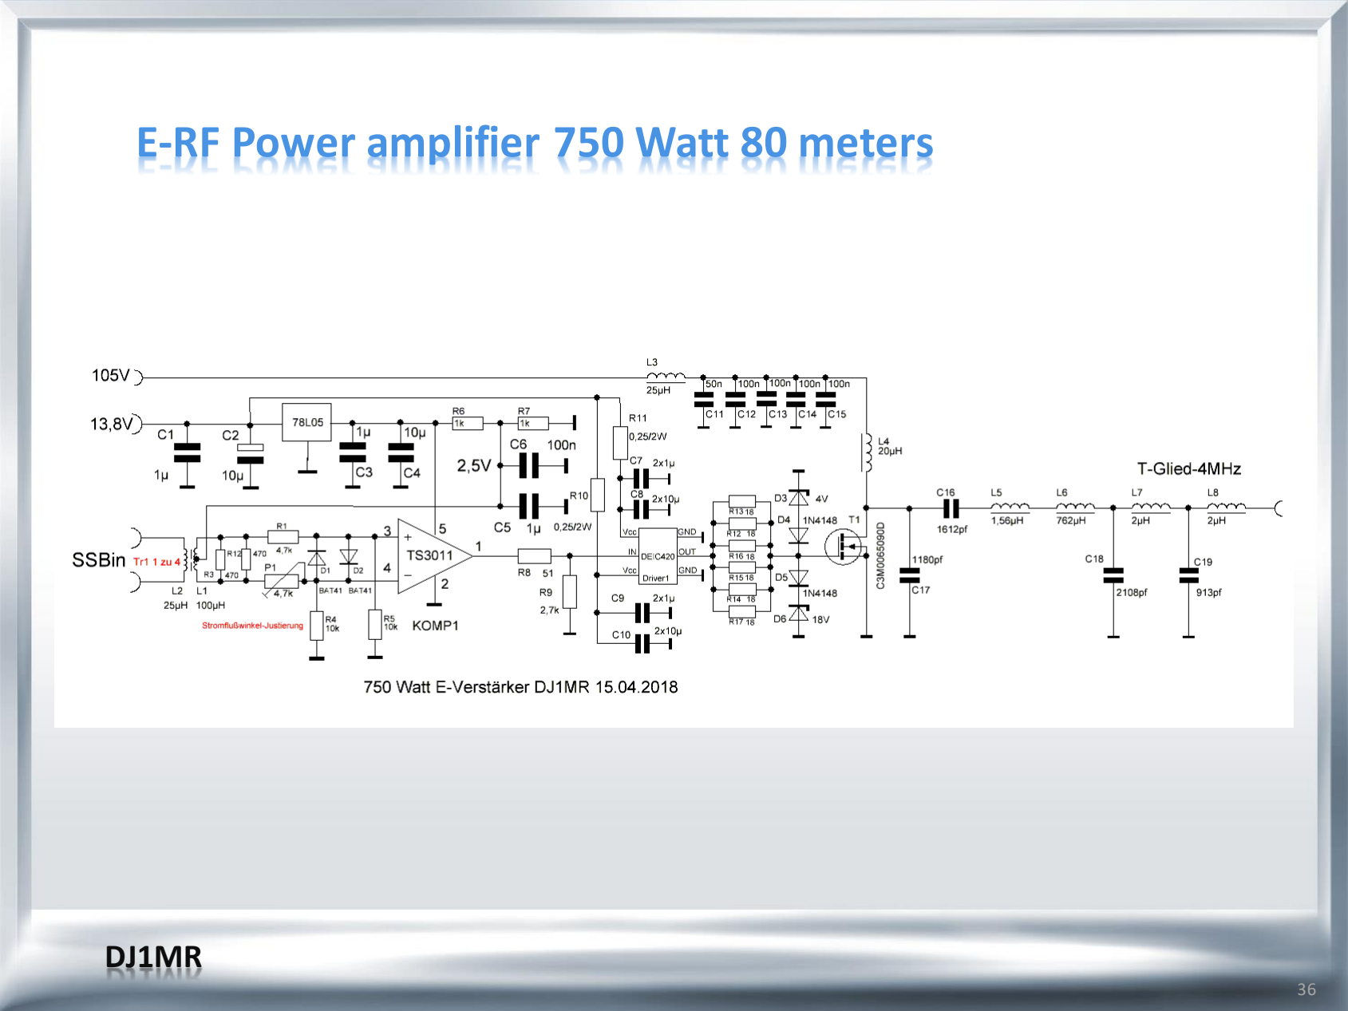
[picture p121: page 36]

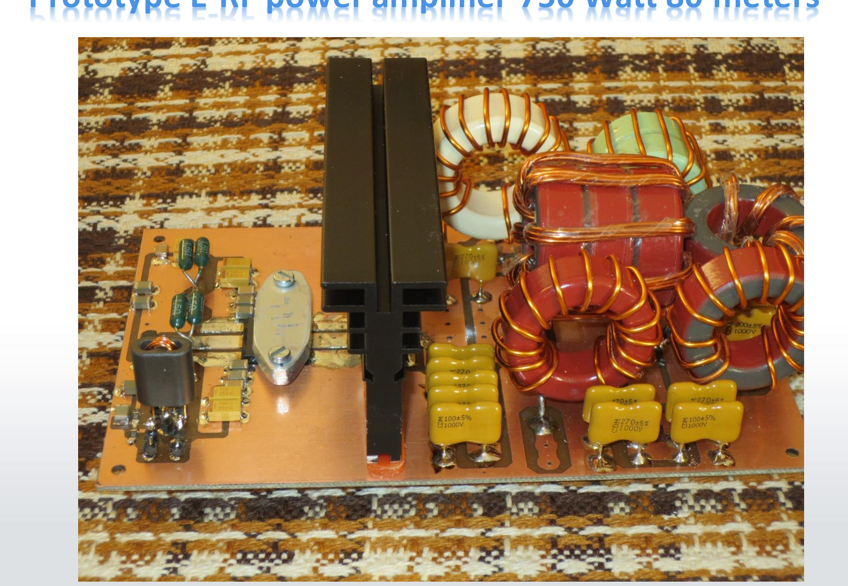
[picture p122: figure]

## Prototype E-RF power amplifier 750 Watt 80 meters

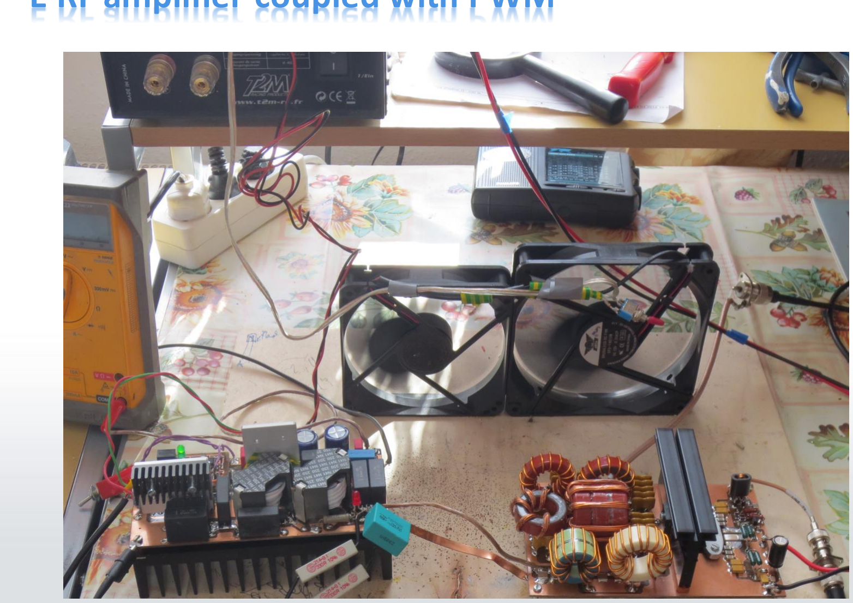
[picture p123: figure]

## E RF amplifier coupled with PWM

## PCB layout E RF power amplifier

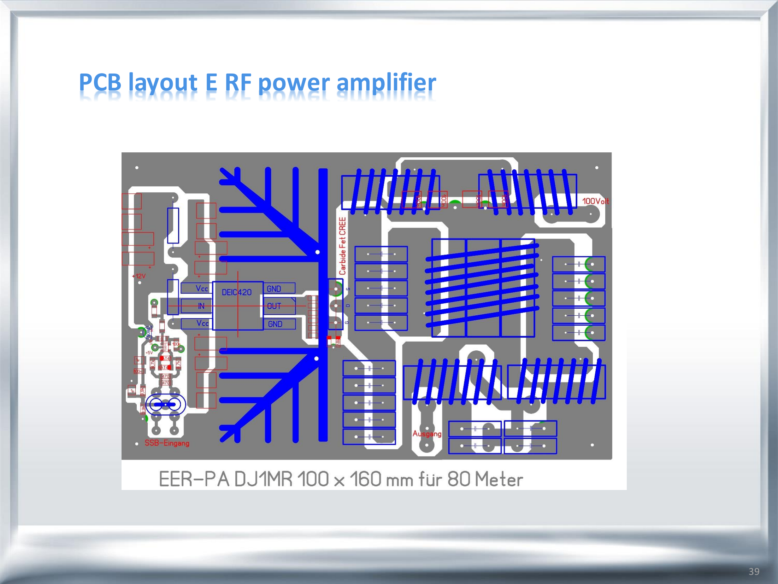
[picture p124: page 39]

## IMD3-E RF power amplifier 750 Watt out without PD

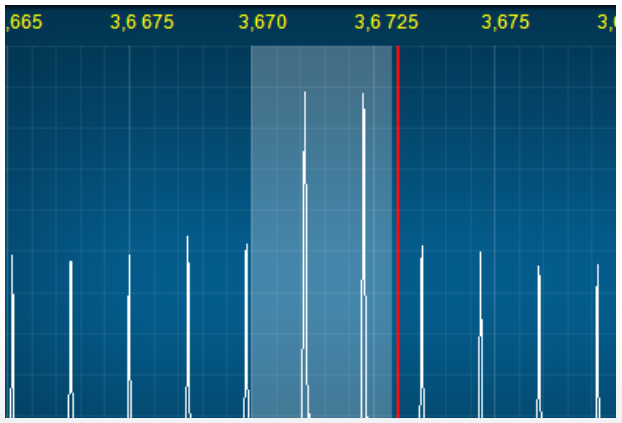
[picture p125: figure]

## Basic requirements on switch mode Rf amp

■ | In reality, a transistor is not a perfect switch and overlap does, in fact, limit efficiency.
■ | In the switch-mode power amplifier, an output resonator helps to shape the waveform by blocking harmonic components of the voltage and current and to keeps these components from reaching the load.
■ | Consequently, only fundamental current is passed to the load and only fundamental voltage is generated over the resonator.
■ | A flywheel effect is created generating sinusoidal voltage and current in the load.

## Class-E/F Family of ZVS switching amplifiers

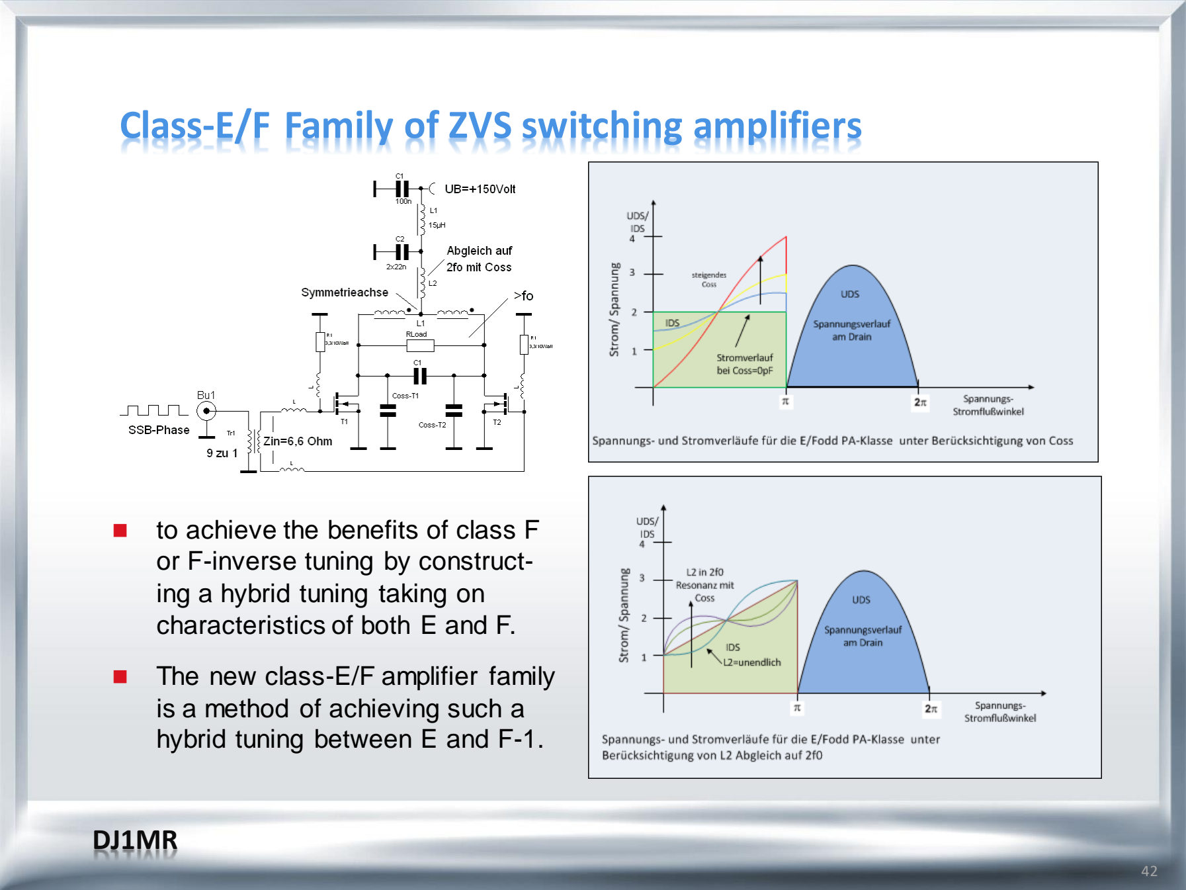
[picture p126: page 42]

■ | to achieve the benefits of class F or F-inverse tuning by construct- ing a hybrid tuning taking on characteristics of both E and F.
■ | The new class-E/F amplifier family is a method of achieving such a hybrid tuning between E and F-1.

## Circuit diagram 800 watts E/F power amplifier

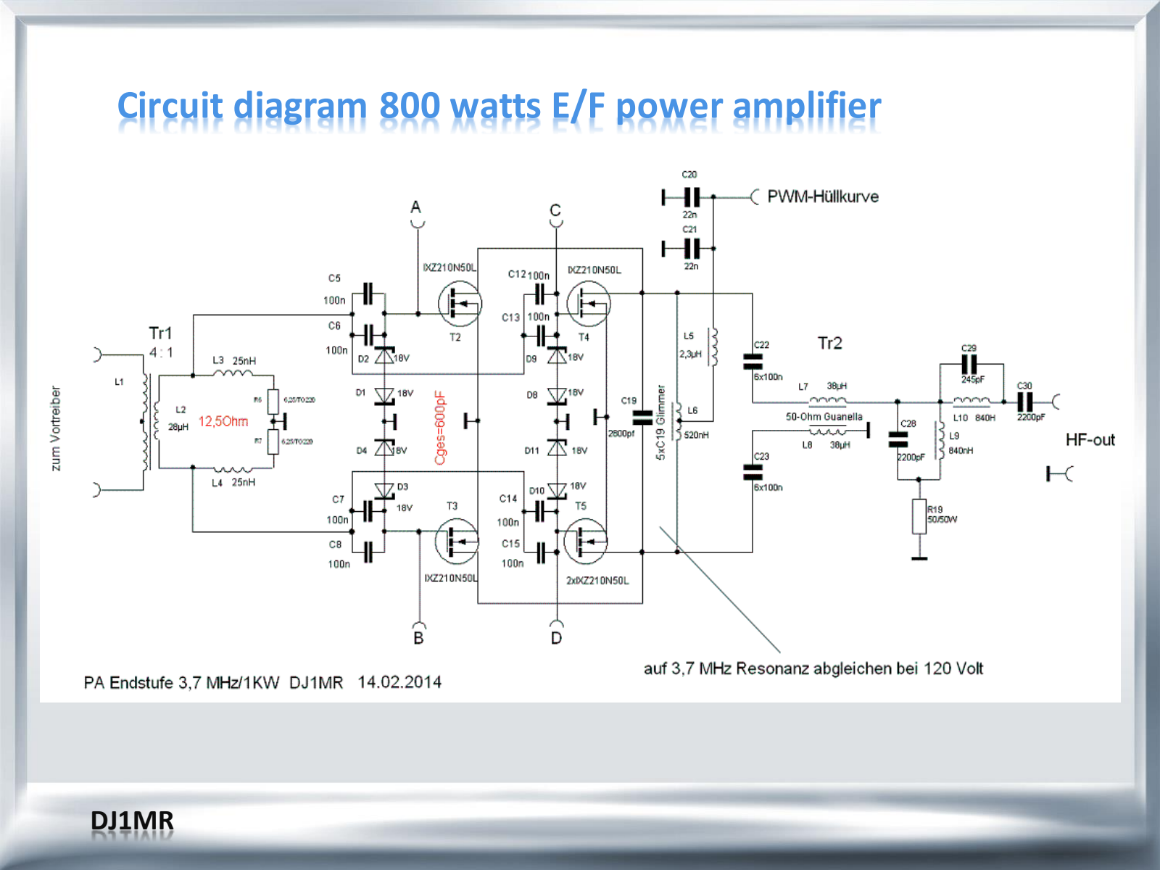
[picture p127: page 43]

Some design problems of E/F switching power ampl.

■ practical PA design problem is the nonlinear behavior of the output capacitance as a function of the supply voltage

■ | allows proper output matching only for a limited drain voltage range.
■ | Tank circuit Q, capacitively or magneticly coupled 1:1 to the load,
■ | means Q=3,6
□ | Very high RF current in the tank circuit
■ | egress coupling balanced to unbalanced with Guanella transformer
■ | low pass filtering, diplex circuit
■ | ingress matching with LC lpf to compensate the gate-source capacity of the
power mosfets

■ overvoltage protection

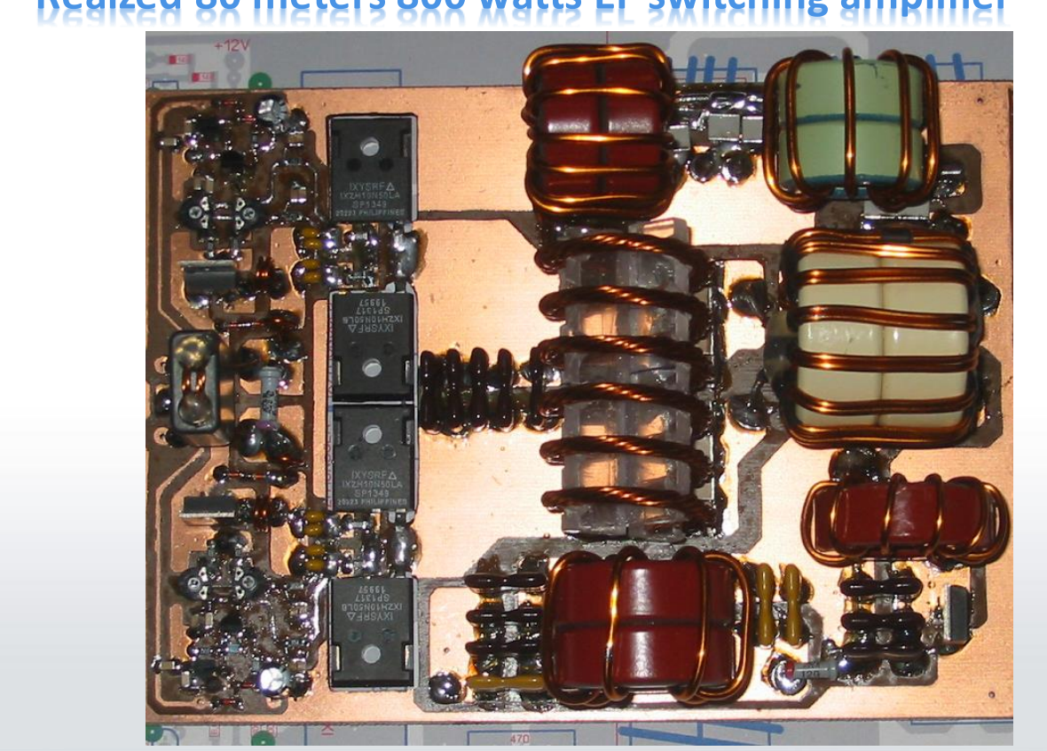
[picture p128: figure]

## Realzed 80 meters 800 watts EF switching amplifier

## Circuit diagram of a two stage driver amplifier

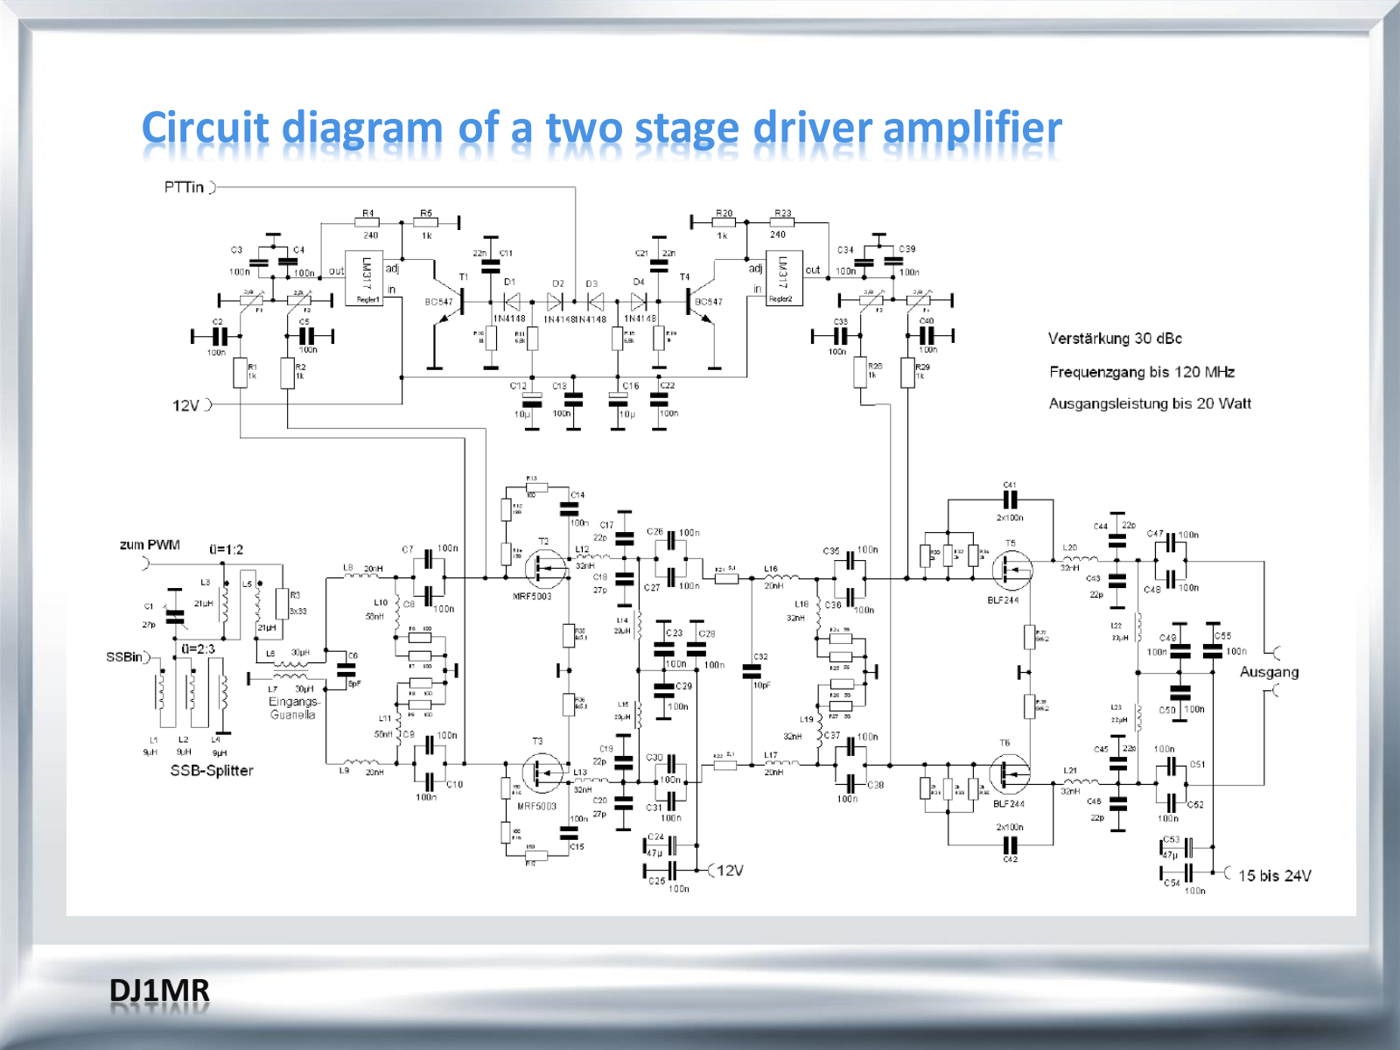
[picture p129: page 46]

## two stage driver amplifier

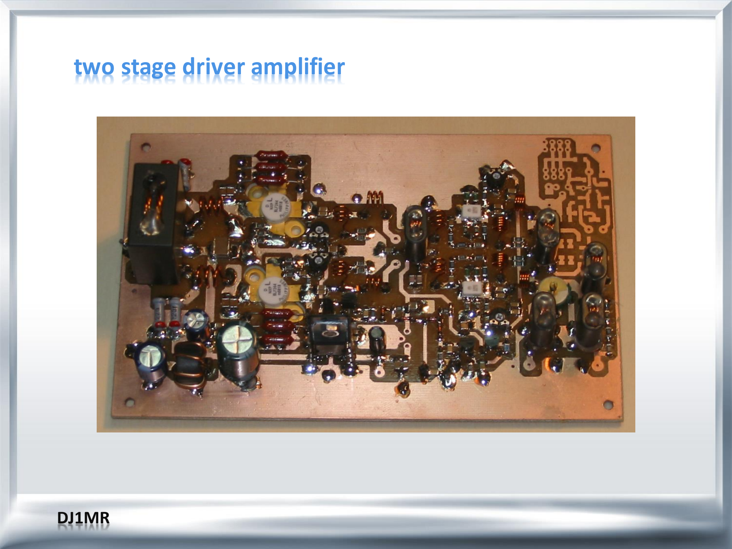
[picture p130: page 47]

## Driver signals in limiting mode

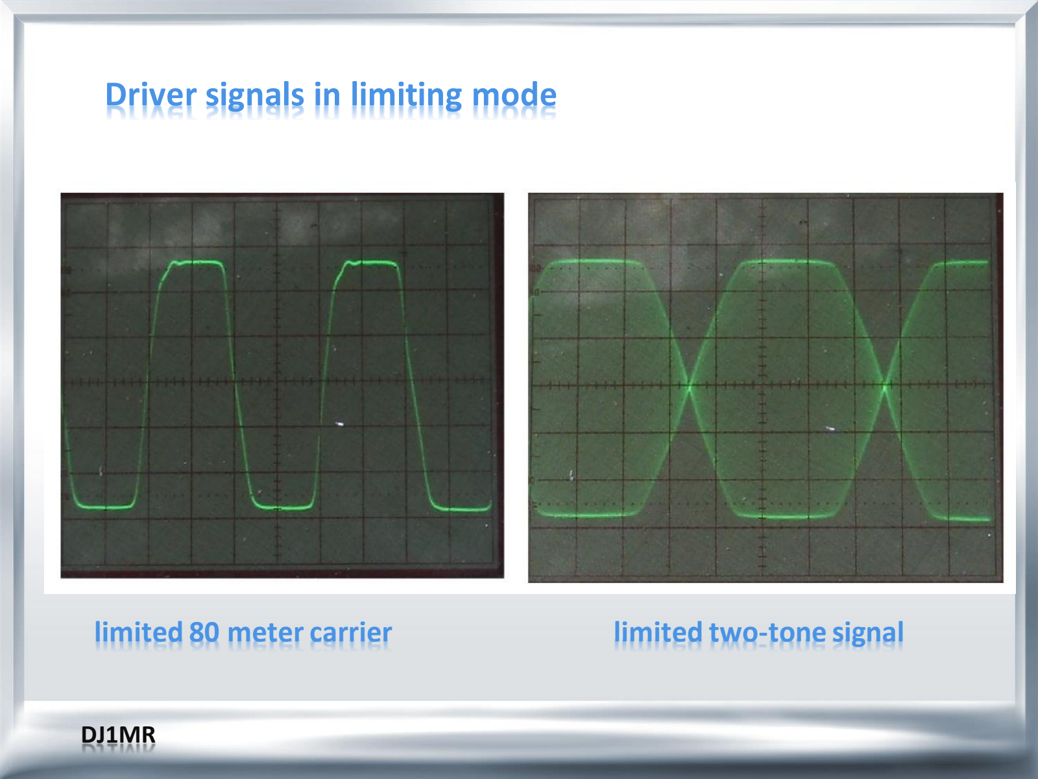
[picture p131: page 48]

limited 80 meter carrier | limited two-tone signal

## THANK YOU

## QUESTIONS?

□ | URL for more information:
□ | http://www.dl0sdr.de/forum/
