F6ITU/ET-EER-Project/DJ1MR/End_2018 files/Controller-PWM-Current.jpg

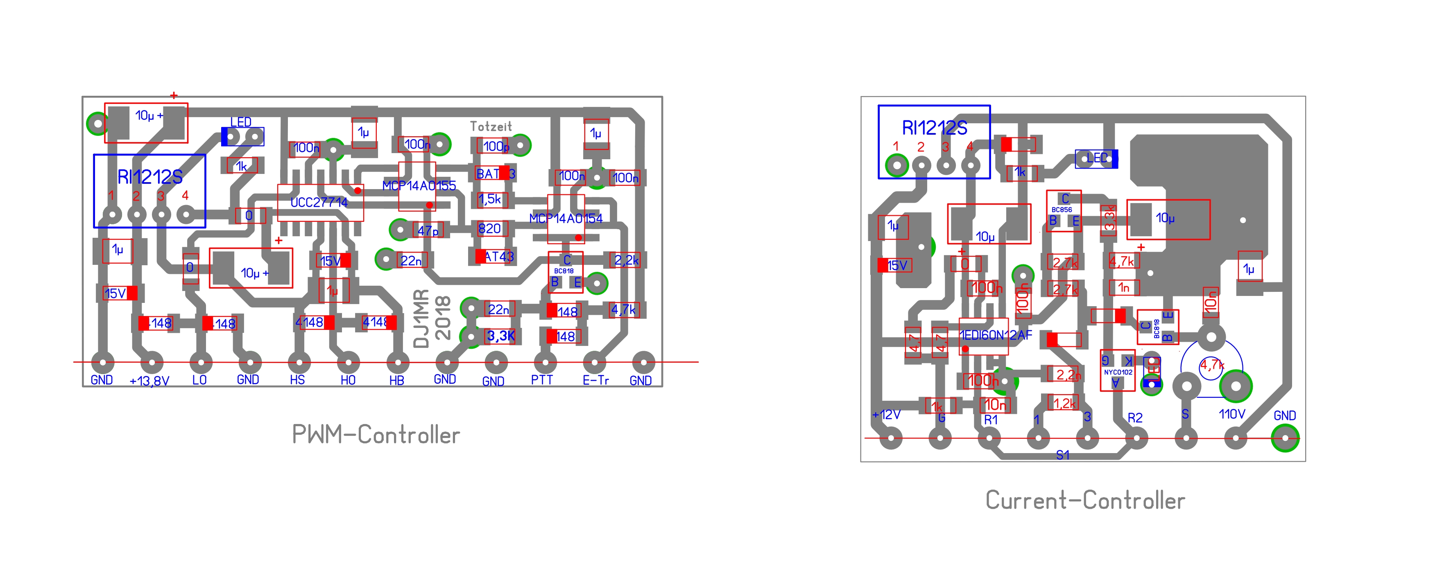
DJ1MR/End_2018 files/Controller-PWM-Current.jpg
