F6ITU/ET-EER-Project/DJ1MR/End_2018 files/Current-Controllert.jpg

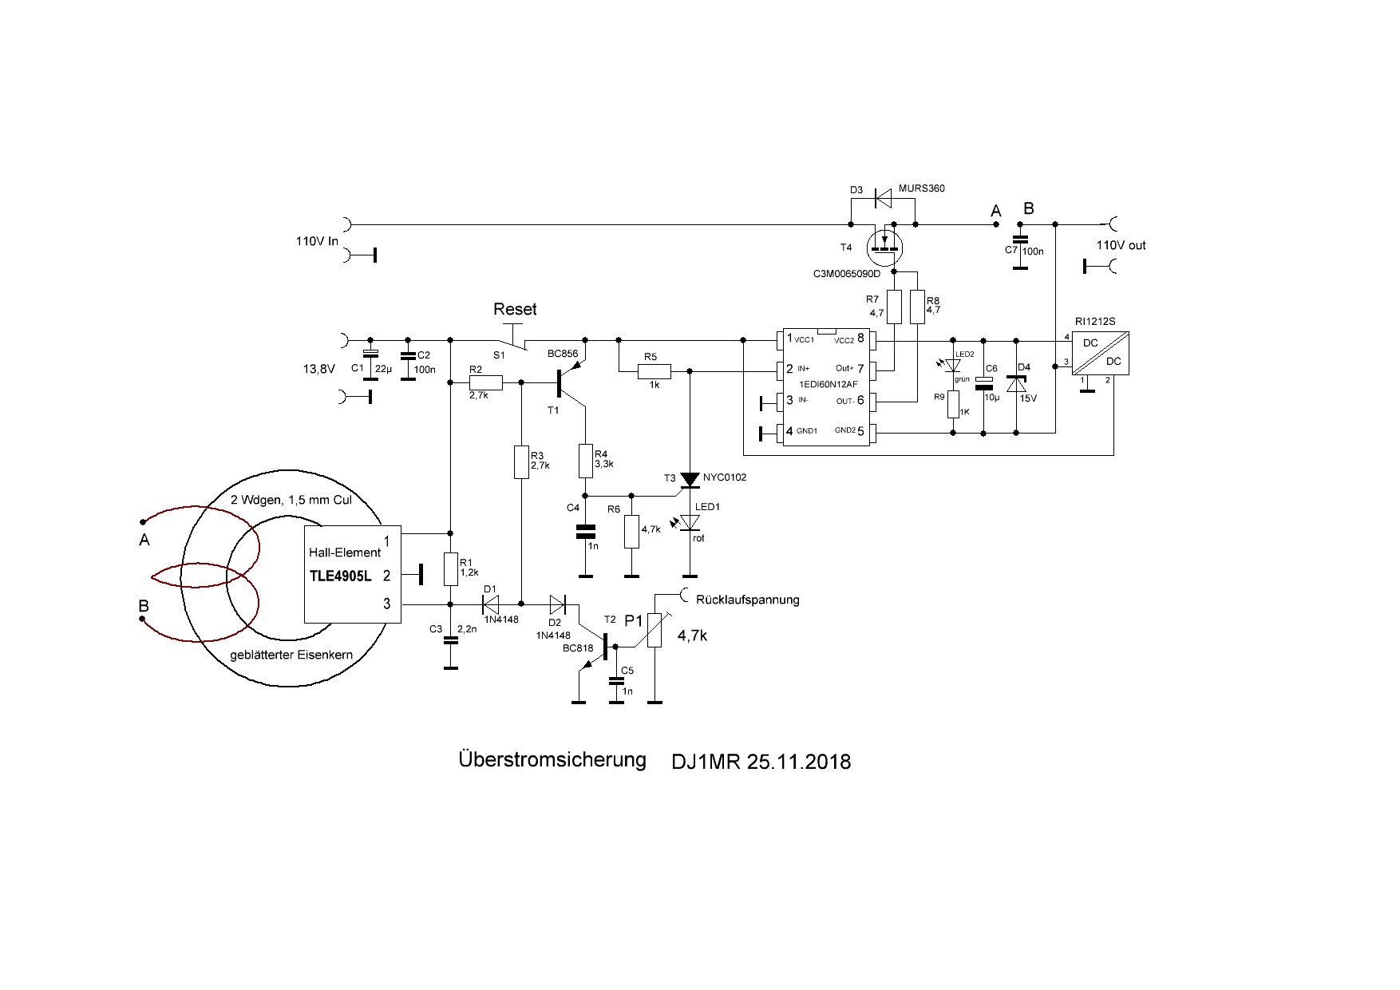
DJ1MR/End_2018 files/Current-Controllert.jpg
