F6ITU/ET-EER-Project/DJ1MR/End_2018 files/Digital-Treiber.jpg

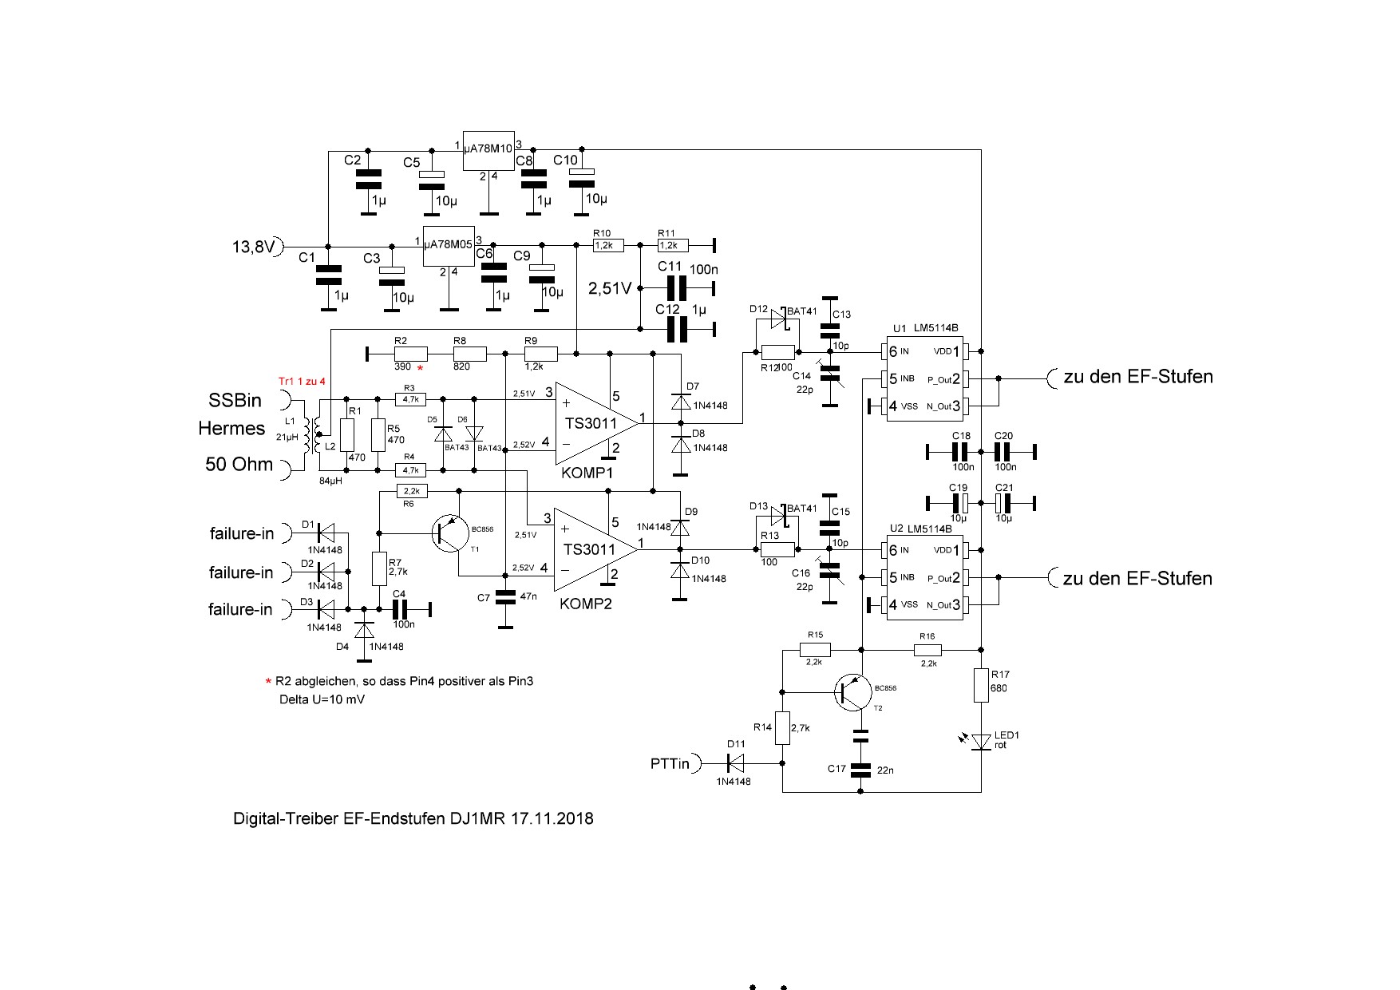
DJ1MR/End_2018 files/Digital-Treiber.jpg
