F6ITU/ET-EER-Project/DJ1MR/End_2018 files/EF-Endstufe-digital-GAN-Fets.jpg

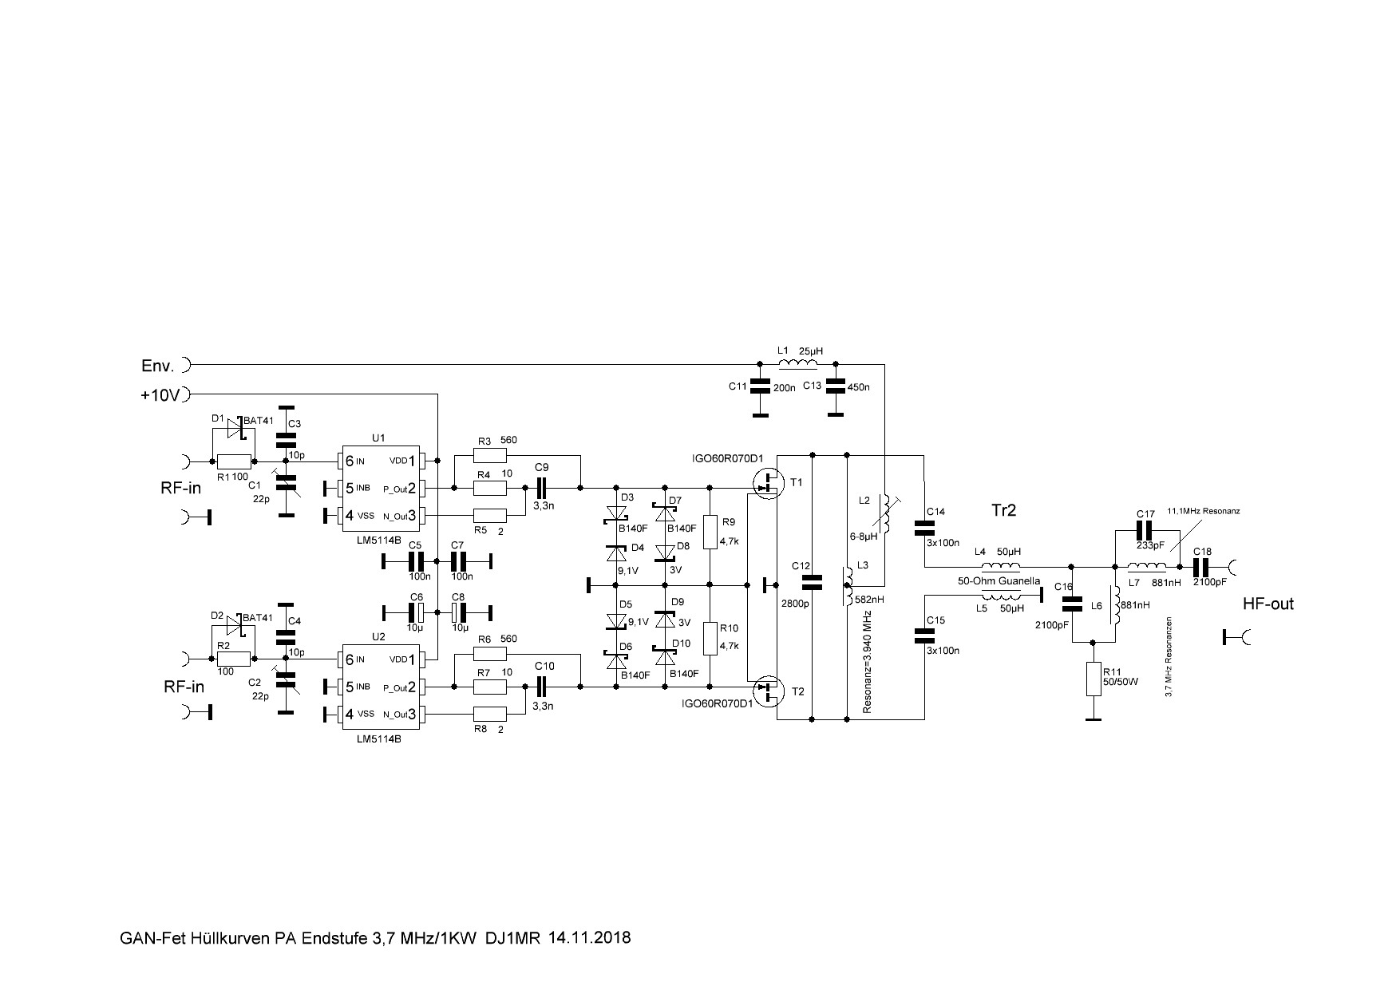
DJ1MR/End_2018 files/EF-Endstufe-digital-GAN-Fets.jpg
