F6ITU/ET-EER-Project/DJ1MR/End_2018 files/PWM-Basic-PCB.JPG

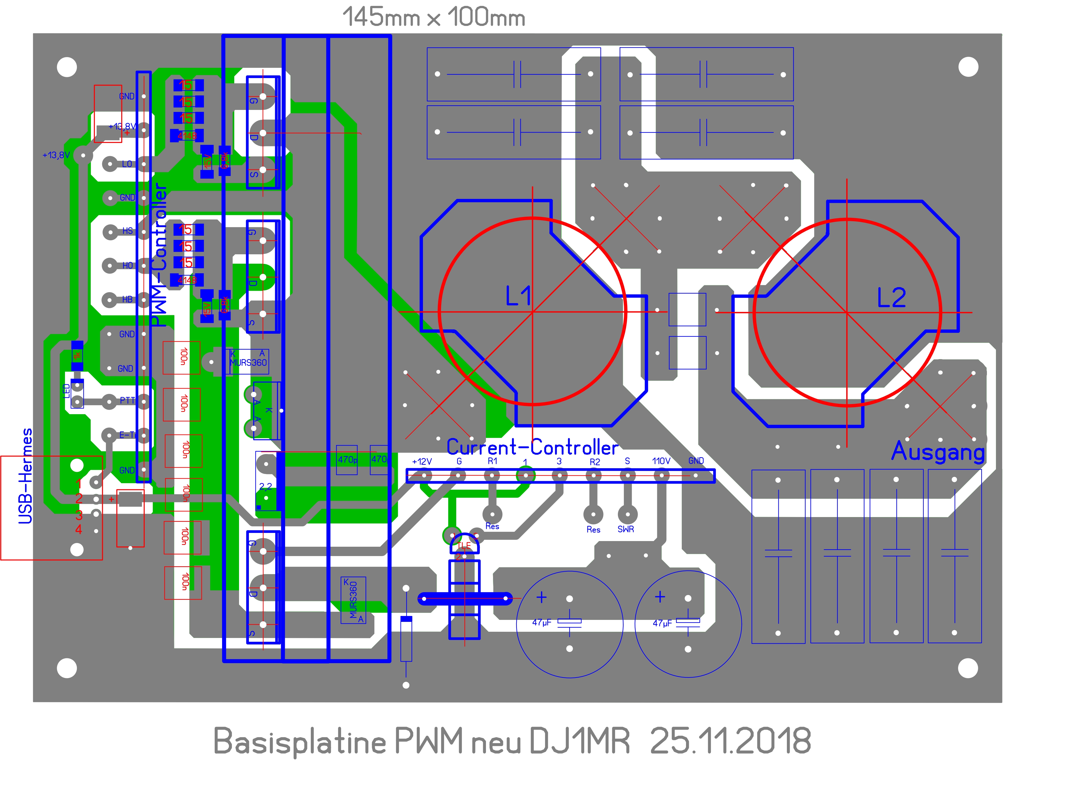
DJ1MR/End_2018 files/PWM-Basic-PCB.JPG
