F6ITU/ET-EER-Project/DJ1MR/End_2018 files/PWM-circuit-diagramTotzeit.jpg

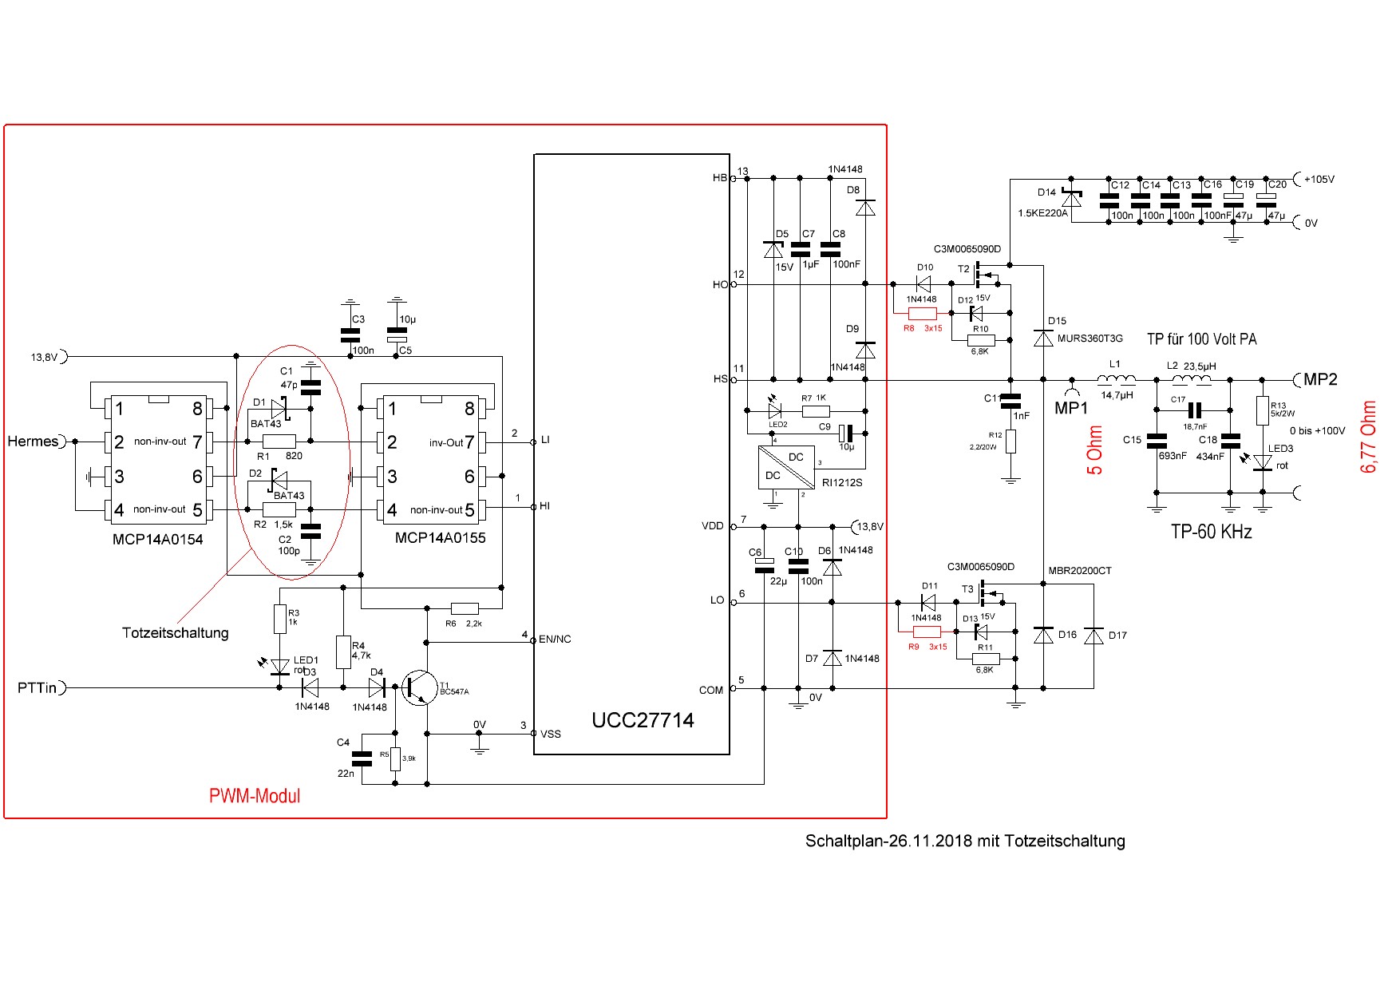
DJ1MR/End_2018 files/PWM-circuit-diagramTotzeit.jpg
