F6ITU/ET-EER-Project/DJ1MR/PCB Layout & BOM/BOM-PWM.XLSX

Stückliste PWM
Bezeichnung im SP | Wert | Typ, Spannung, Leistung | Lieferant | Bemerkungen
C1 | 100n | SMD , Bauform 1206 | Reichelt
C2 | 22n | SMD , Bauform 1207 | Reichelt
C3 | 100µ | Elko, Becher,25 Volt | Reichelt
C4 | 22µ | SMD Tantal | Reichelt
C5 | 1µF | SMD, Bauform 1210 | Reichelt
C6 | 100nF | SMD , Bauform 1206 | Reichelt
C7 | 22µ | Elko, Becher,25 Volt | Reichelt
C8 | 100n | SMD , Bauform 1206 | Reichelt
C9 | 1nF oder 2x 470 pF | SMD , Bauform >1210, 500 Volt | Reichelt
C10 x 2 | 100n | Kemet, 2X7, 500 Volt | Mouser oder Digikey
C11 x 2 | 100n | Kemet, 2X7, 500 Volt | Mouser oder Digikey
C12 x 2 | 100n | Kemet, 2X7, 500 Volt | Mouser oder Digikey
C13 | 693nF | Filmkondensator Epcos oder VISHAY, aus vier Einzelwerten zusammensetzen, ich hatte 1000 Volt, bei Euch reichen 500 Volt | Digikey | müßt Ihr neu berechnen für 50 Volt, bedenkt Euren hohen Strom!!!!!!!!!, impulsfest wäre gut
C14 x 2 | 100nF | Kemet, 2X7, 500 Volt | Mouser oder Digikey
C15 | 18,7nF | Cauer Pol Kondensator für 240 KHz Resonanz, Keramik, 500 Volt, SMD oder bedrahtet, aus zwei bis drei zusammensetzen | Reichelt | müßt Ihr neu berechnen für 50 Volt
C16 | 434nF | Filmkondensator Epcos oder VISHAY, aus vier Einzelwerten zusammensetzen, ich hatte 1000 Volt, bei Euch reichen 500 Volt | Digikey | müßt Ihr neu berechnen für 50 Volt
C17 | 47µ | Becher, 350 Volt
C18 | 47µ | Becher, 350 Volt | Reichelt
D1 | 1N4148 | SMD Mini-Melf | Reichelt
D2 | 1N4148 | SMD Mini-Melf | Reichelt
D3 | 1N4148 | SMD Mini-Melf | Reichelt
D4 | 15V Z-Diode | SMD Mini-Melf | Reichelt
D5 | BAT43 | SMD Mini-Melf | Reichelt
D6 | BAT43 | SMD Mini-Melf | Reichelt
D7 | BAT43 | SMD Mini-Melf | Reichelt
D8 | BAT43 | SMD Mini-Melf | Reichelt
D9 | 1N4148 | SMD Mini-Melf | Reichelt
D10 | 1N4148 | SMD Mini-Melf | Reichelt
D11 | 1N4148 | SMD Mini-Melf | Reichelt
D12 | 15V Z-Diode | SMD Mini-Melf | Reichelt
D13 | 15V Z-Diode | SMD Mini-Melf | Reichelt
D14 | 15V Z-Diode | SMD Mini-Melf | Reichelt
D15 | 1.5KE220A | Überspannungsschutzelement | Digikey
D16 | MURS360T3G | SMD | Reichelt oder Digikey
D17 | MURS360T3G | SMD | Reichelt oder Digikey
D18 | 1/2 MBR20200CT | TO220 Doppel-Shottky Diode | Digikey
D19 | 1/2 MBR20200CT | TO220 Doppel-Shottky Diode | Digikey
D20 | 1/2 MBR20200CT | TO220 Doppel-Shottky Diode | Digikey
D21 | 1/2 MBR20200CT | TO220 Doppel-Shottky Diode | Digikey
L1 | 14,7µH | RM 14 Kerne, 1 mm Luftspalt, N41, Draht 7x 0,75 mm CU-Lack verdrillt und isoliert | Bürklin | müßt Ihr neu berechnen für 50 Volt, wie es mit RFSim99 geht habe ich Euch gezeigt
L2 | 23,5µH | RM 14 Kerne, 1 mm Luftspalt, N41, Draht 7x 0,75 mm CU-Lack verdrillt und isoliert | Bürklin | müßt Ihr neu berechnen für 50 Volt, wie es mit RFSim99 geht habe ich Euch gezeigt
LED1 | rot | 2,5 mm Rastermaß | Reichelt
LED2 | rot | 2,5 mm Rastermaß | Reichelt
LED3 | rot | 2,5 mm Rastermaß | Reichelt
R1 | 1k | SMD , Bauform 1206 | Reichelt
R2 | 4,7k | SMD , Bauform 1206 | Reichelt
R3 | 3,9k | SMD , Bauform 1206 | Reichelt
R4 | 2,2k | SMD , Bauform 1206 | Reichelt
R5 | 1K | SMD , Bauform 1206 | Reichelt
R6 | 3x18 | SMD , Bauform 1206 | Reichelt
R7 | 3x18 | SMD , Bauform 1206 | Reichelt
R8 | 3x18 | SMD , Bauform 1206 | Reichelt
R9 | 6,8K | SMD , Bauform 1206 | Reichelt
R10 | 6,8K | SMD , Bauform 1206 | Reichelt
R11 | 6,8K | SMD , Bauform 1206 | Reichelt
R12 | 2,2/20W | TO220 | Reichelt
R13 | 4,7/20W | TO220 | Reichelt
R14 | 5k/2W | Metallschichwiderstand, axial | Reichelt
T1 | BC547A | SMD | Reichelt
T2 | C3M0065100K | Silizium Vierpin Carbide Fet | Digikey
T3 | C3M0065100K | Silizium Vierpin Carbide Fet | Digikey
T4 | C3M0065100K | Silizium Vierpin Carbide Fet | Digikey
U | MCP14E11 | Eingangtreiber, SMD | Reichelt
U2 | UCC27714 | High-Low-Side Driver, SMD | Digikey
