F6ITU/ET-EER-Project/(list of files, drawings)

Other design files:
DJ1MR/PCB Layout & BOM/Att-Sequ.lay
DJ1MR/PCB Layout & BOM/Endstufe-Balun-zweistufig.lay
DJ1MR/PCB Layout & BOM/Endstufe-einstufig-einstufig.lay
DJ1MR/PCB Layout & BOM/Filter.lay
DJ1MR/PCB Layout & BOM/PWM-circuit-diagram-four-pin.spl7
DJ1MR/PCB Layout & BOM/PWM-Layout-vier-Pin-Mosfets-V3.lay6
DJ1MR/PCB Layout & BOM/PWM-three-pin-Layout.lay6
DJ1MR/PCB Layout & BOM/Richtkoppler-Layout.lay
DK7XL/Adapter for HERMES.lay6
